class-ab/open-soccer/PCBs/KICAD PARTS/OpenMV RT0162 CAD/ov5640.png

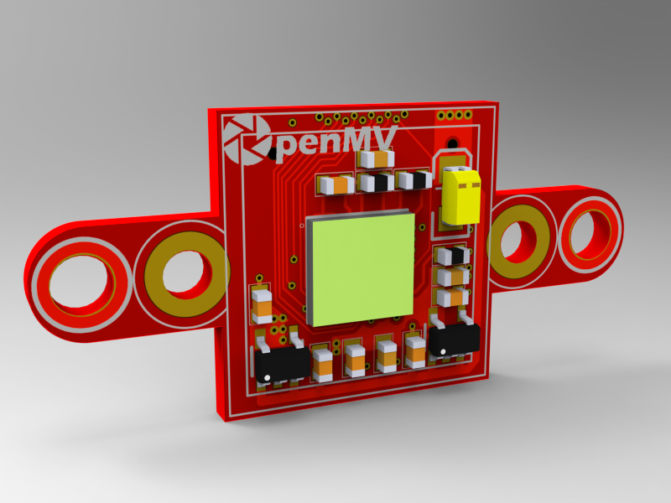
PCBs/KICAD PARTS/OpenMV RT0162 CAD/ov5640.png
