class-ab/open-soccer/README.md

contains all the PCBs, code and general shared documentation used in the creation of Mindstormers' open soccer robot/s (2026+)

CAD: https://cad.onshape.com/documents/fc0a5e085ca7f56b4458a98d/w/3d7a112d05c35eb898b84bfe/e/c55f60db607fb82f3faf3afa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
