class-ab/open-soccer/software/simulation/README.md

# RCJ Open Soccer — 2D Simulation (SFML)

A minimal 2D simulation of an RCJ Open Soccer field with a single robot (with a
frontal dribbler) and a ball. It runs the real robot firmware on a background
thread through a simulator HAL, so the robot's `loop()` runs while the render
loop animates the field.

## Field constants

- Total green area: 2430 mm (width) x 1820 mm (height), matching robot localization
- White lines: 50 mm thick, positioned 250 mm from the walls on every side
  (these form the play border)
- Goals: 450 mm wide, centered on the left and right short sides, 74 mm deep
  from the inner edge of the white line
- Robot: 180 mm diameter (configurable) with a 40 mm wide frontal dribbler bar
- Ball: 40 mm diameter

All constants live at the top of `src/main.cpp` and are expressed in
millimetres, so sizes and the rendering scale can be tweaked easily.

## Physics / behaviour

- Ball and robot are clamped to the field walls; goals are solid boxes.
- Dragging/dropping the ball places it exactly where the cursor is (drag
  follows the mouse, clamped only to the field). It can be placed over or
  behind a goal — it no longer snaps to the goal surface.
- Rolling ball friction, wall/goal bounces, and robot-ball contact are
  simulated.
- Dribbling: the sim reads the shared `dribblerShouldRun` flag. When the robot
  requests the dribbler and the ball touches the frontal dribbler bar, the ball
  is held against the bar and follows the robot through translation and
  rotation. It releases when the dribbler is switched off or the user grabs it.
- No scoring yet: the ball is kept out of the goal boxes themselves.

## Build

Requires CMake and SFML. On Windows the project has been built with Visual
Studio 2022 (generated with `cmake -G "Visual Studio 17 2022"`).

```
cmake -S . -B build
cmake --build build --config Release
```

Then run `build\Release\simulation.exe` (Windows) or `build/simulation`
(Linux/macOS).

> The sim runs the current robot entry point, vision, drivebase, state, and
> strategy modules from `../code/src`. Simulator localization, IMU, radio,
> display, battery, dribbler, and kicker adapters replace hardware I/O while
> preserving the firmware interfaces. Robot control runs once per simulation
> frame; the position and heading PID values come from `robot_config.h`.

If CMake cannot find SFML, install it for your platform (vcpkg, apt, brew, …)
and make sure it is discoverable by CMake.

## Usage

Mouse:
- Left-drag on the **robot** to move it (uses goal collision).
- Left-drag on the **ball** to move it (follows the cursor, field-only).
  Releasing places the ball exactly there.

Keyboard:
- `R` — reset robot to field centre
- `Space` — enable or disable the robots
- `Escape` — quit (or cancel an in-progress HUD text edit)

HUD panel (right side):
- **Enable / Disable** buttons toggle the robot firmware run state.
- **Move** and **Rot** fields set calibration scales (default `1.0`) when
  applying the robot's active `MoveProfile`. Linear motion uses the configured
  robot speed and a `0.9` slip modifier.
- Readouts: BallPacket (detected / angle / distance), MoveProfile (active /
  direction / speed / rotation), and Dribbler + Ball held state.

## Files

- `src/main.cpp` — main simulation, physics/collision, rendering, input, HUD
- `src/robot_wrapper.cpp` — runs `setup()`/`loop()` of the firmware on a thread
- `src/sim_hal/` — Arduino-style shim (`Arduino.h`) and simulator time control
- `src/sim_stubs/` — stubbed firmware peripherals (display, IMU, dribbler, battery)
- `src/sim_state.cpp` — shared `currentMoveProfile`, `dribblerShouldRun`, etc.
- `CMakeLists.txt` — CMake project
