class-ab/open-soccer/hardware/mirror/mirror_profile.csv

radius_mm | height_mm
0.0 | 42.74874000408491
0.008395794528244623 | 42.74874000408491
0.016791598710504473 | 42.74876293276296
0.02518742670333748 | 42.74880878906418
0.033583292661637655 | 42.748877570862064
0.04197921073758713 | 42.7489692749592
0.05037519507960946 | 42.7490838970883
0.058771259831324495 | 42.74922143191357
0.06716741913050564 | 42.74938187303248
0.07556368710803954 | 42.749565212977835
0.08396007788688907 | 42.74977144322013
0.09235660558105975 | 42.75000055417042
0.10075328429457031 | 42.75025253518333
0.10915012812042778 | 42.750527374560534
0.11754715113960738 | 42.75082505955451
0.125944367420038 | 42.751145576372615
0.13434179101559346 | 42.75148891018157
0.1427394359650898 | 42.7518550451121
0.15113731629128987 | 42.75224396426412
0.15953544599991443 | 42.75265564971201
0.1679338390786611 | 42.75309008251036
0.17633250949623125 | 42.753547242699945
0.1847314712013652 | 42.75402710931401
0.19313073812188622 | 42.75452966038489
0.2015303241637534 | 42.75505487295083
0.2099302432101243 | 42.7556027230632
0.21833050912042753 | 42.75617318579391
0.22673113572944514 | 42.75676623524316
0.23513213684640571 | 42.75738184454736
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
