class-ab/open-soccer/hardware/mirror/mirror_rays.png

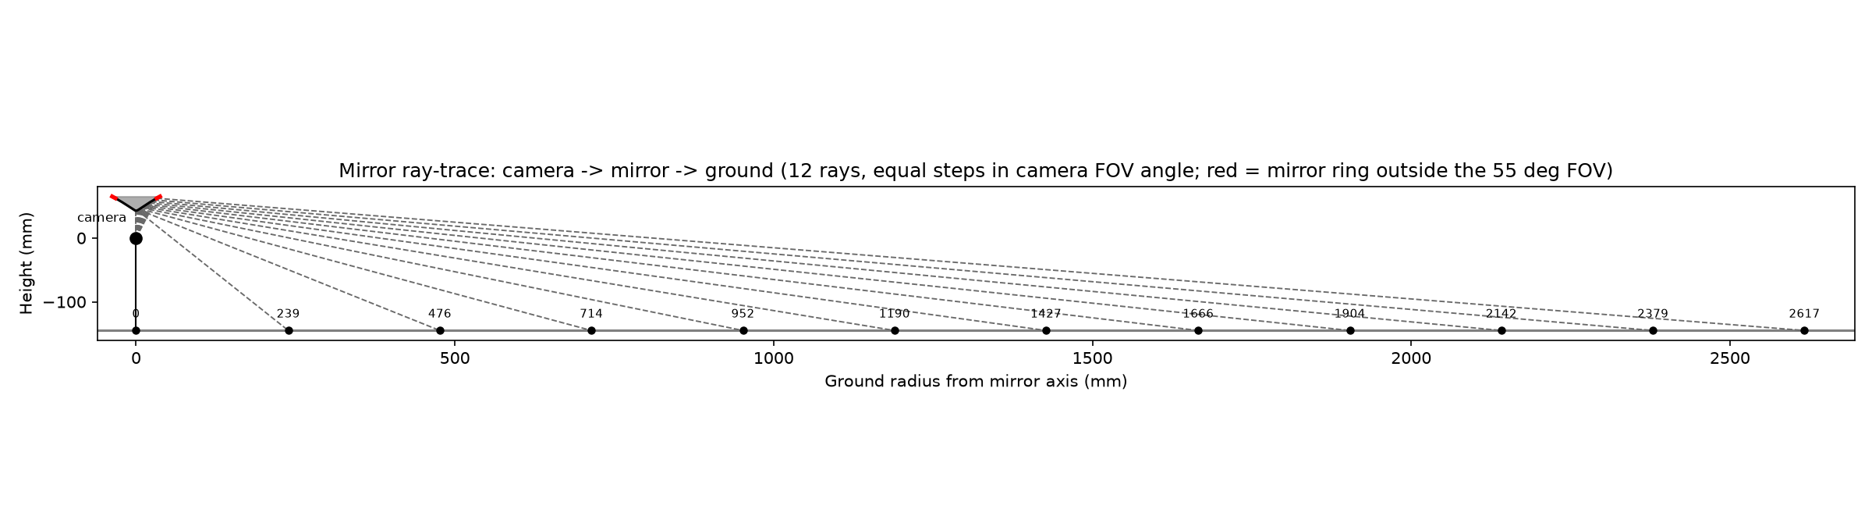
hardware/mirror/mirror_rays.png
