class-ab/open-soccer/PCBs/kicker/v1 review/kicker-bottom-3D.png

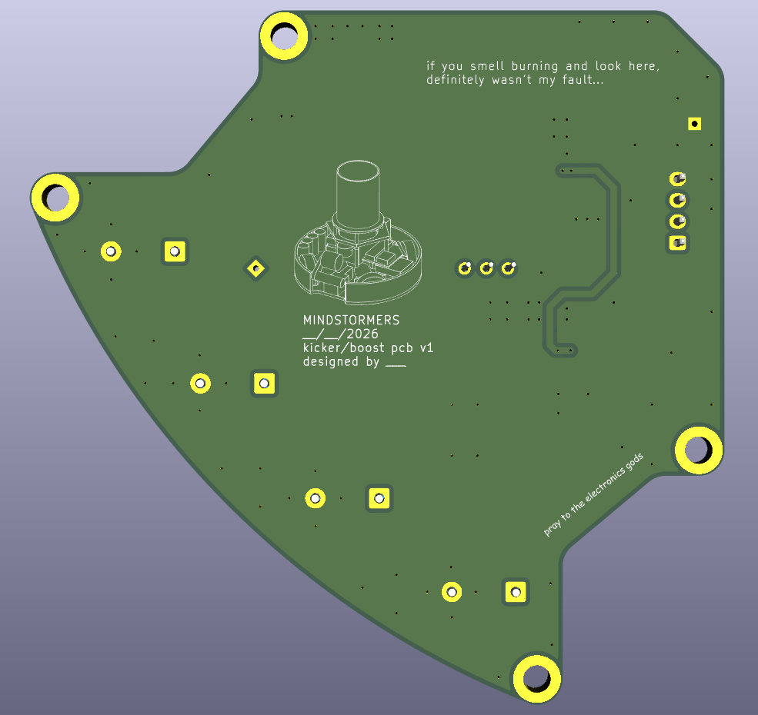
PCBs/kicker/v1 review/kicker-bottom-3D.png
