class-ab/open-soccer/PCBs/kicker/v1 review/PCB-back.png

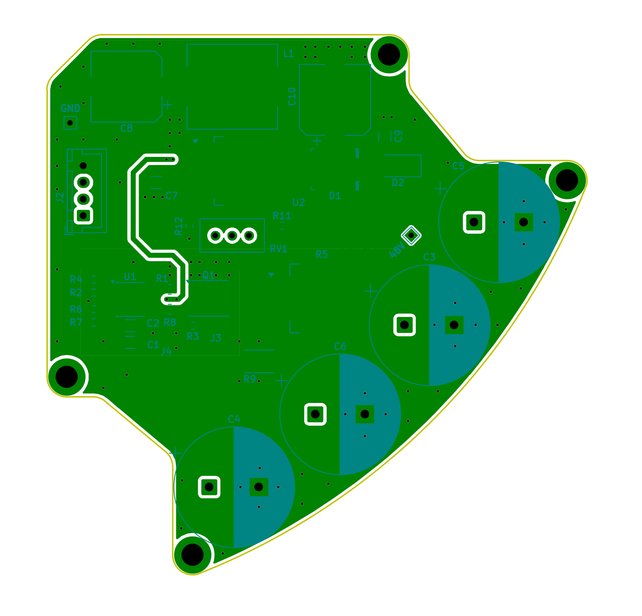
PCBs/kicker/v1 review/PCB-back.png
