class-ab/open-soccer/PCBs/kicker/v1 review/PCB-front.png

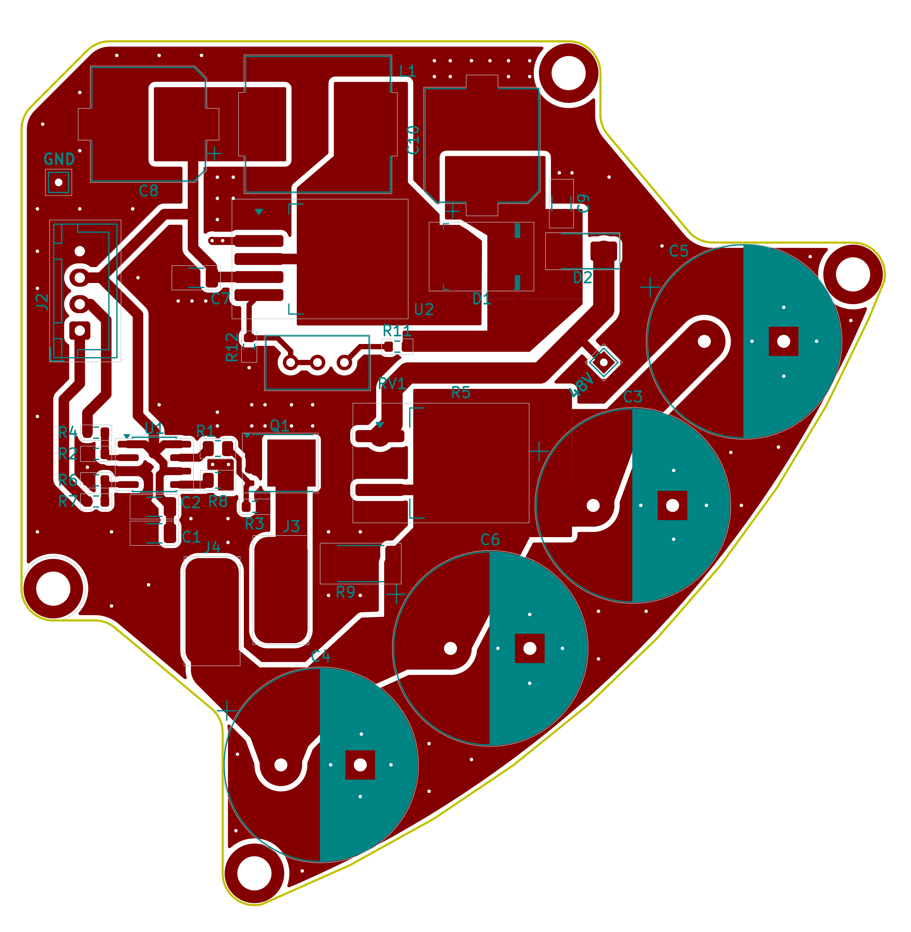
PCBs/kicker/v1 review/PCB-front.png
