class-ab/open-soccer/PCBs/kicker/v1 review/schematic.png

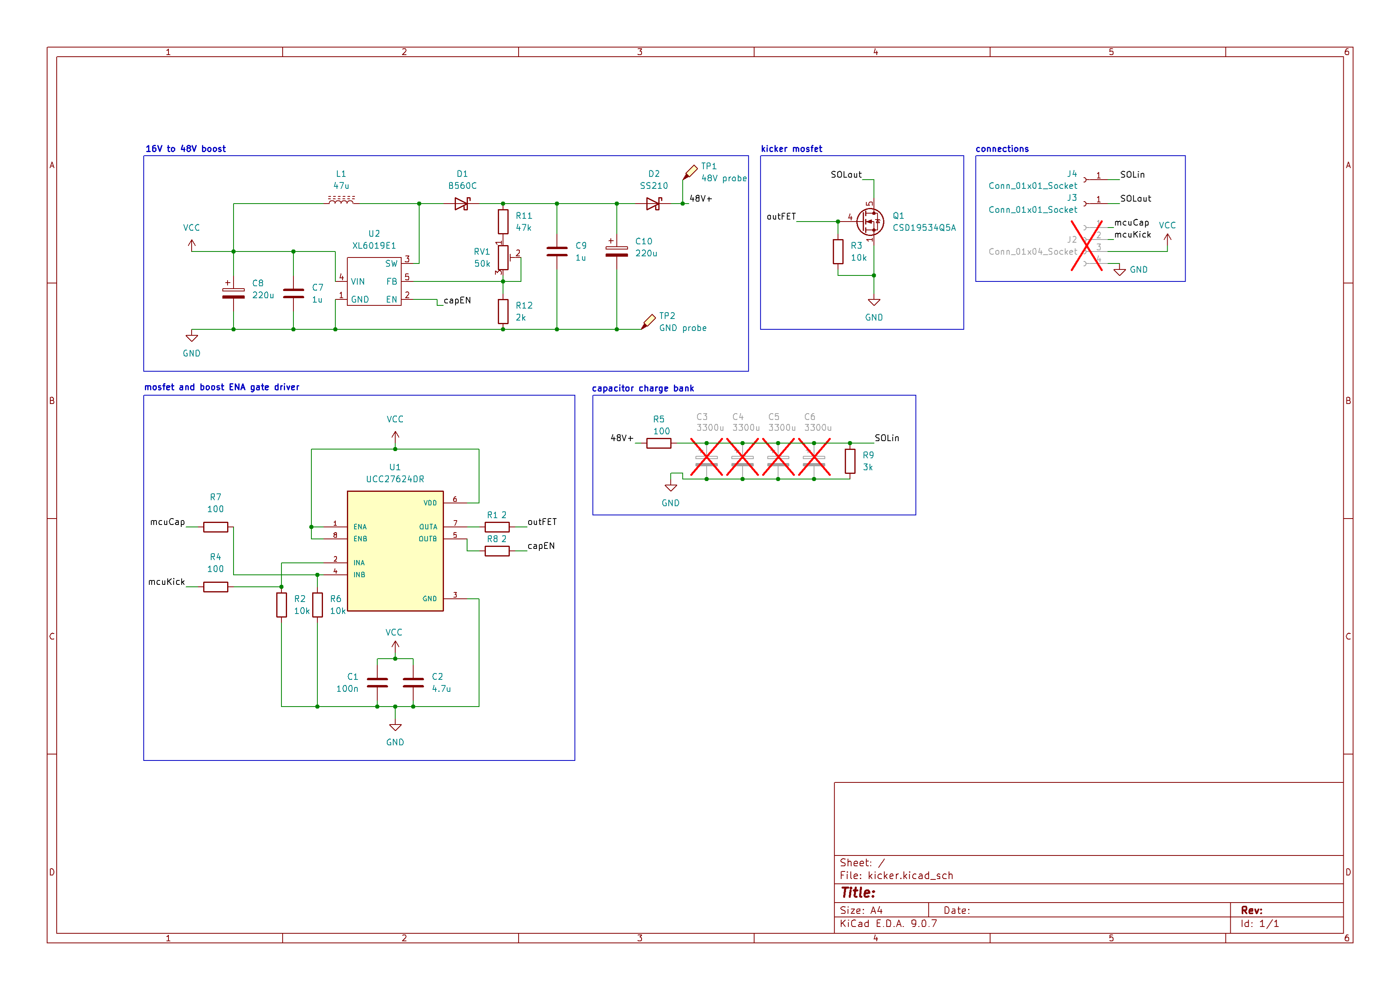
PCBs/kicker/v1 review/schematic.png
