class-ab/open-soccer/PCBs/kicker/v1 review/Screenshot 2026-04-18 172316.png

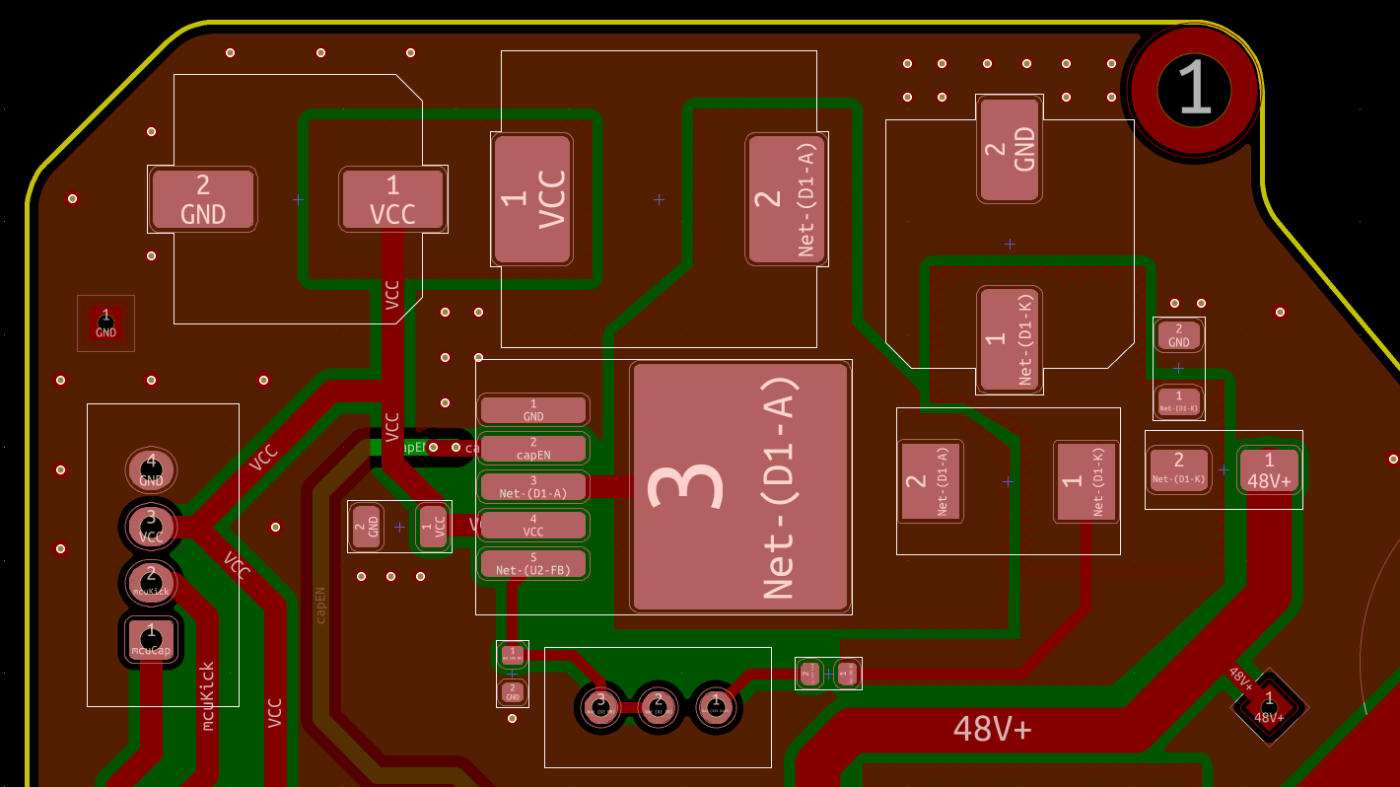
PCBs/kicker/v1 review/Screenshot 2026-04-18 172316.png
