class-ab/open-soccer/robot_strategy.png

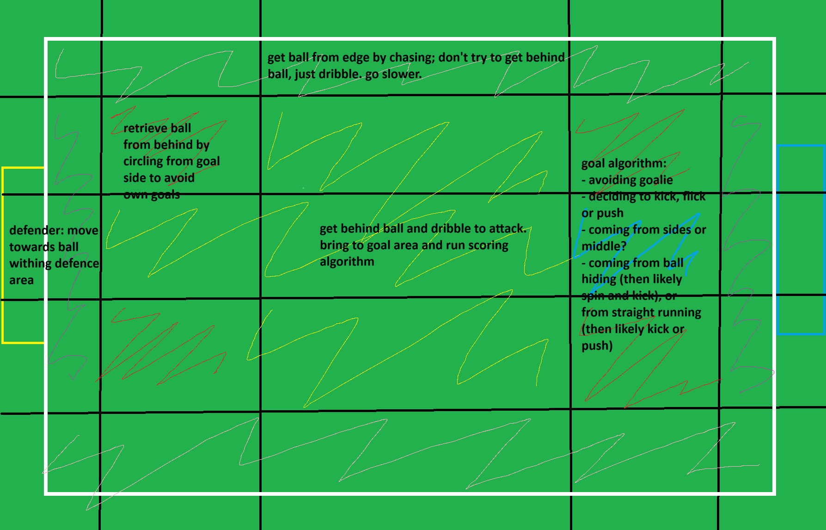
robot_strategy.png
