class-ab/open-soccer/PCBs/KICAD PARTS/OpenMV RT0162 CAD/openmv-cam-rt1062.png

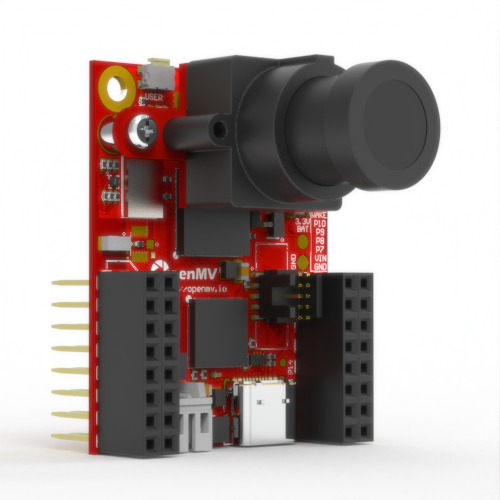
PCBs/KICAD PARTS/OpenMV RT0162 CAD/openmv-cam-rt1062.png
