class-ab/open-soccer/PCBs/KICAD PARTS/OpenMV RT0162 CAD/RT1062 R5.png

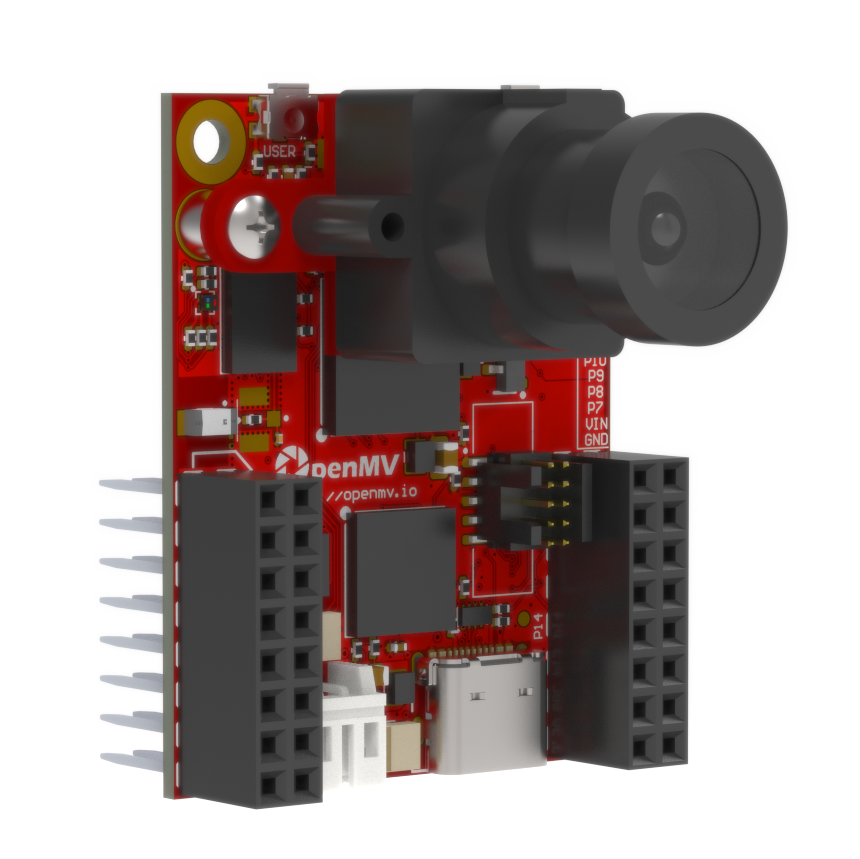
PCBs/KICAD PARTS/OpenMV RT0162 CAD/RT1062 R5.png
