class-ab/open-soccer/PCBs/bottom/bottom PCB.step

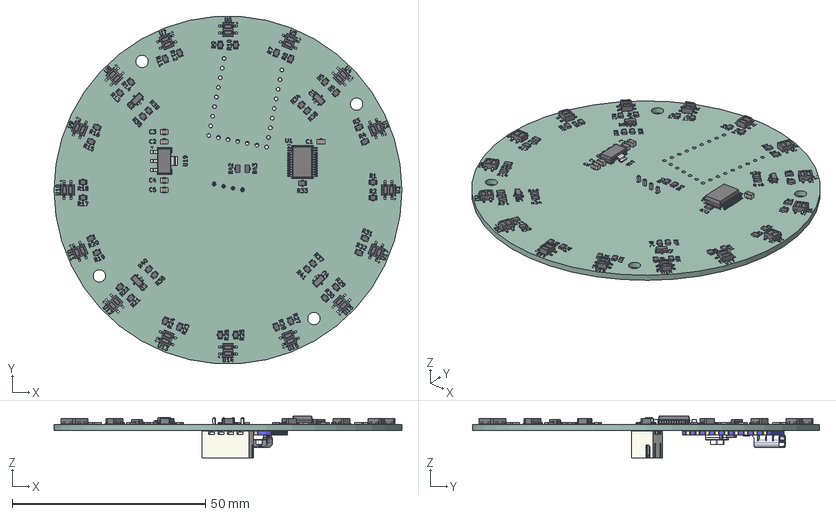
[picture p18: CAD file, 2026-04-25]
PCBs/bottom/bottom PCB.step
90.0 x 89.7 x 10.8 mm
R_0805_2012Metric x 43
SOT-23 x 4
OnSemi_CASE100CY x 16
C_0805_2012Metric x 5
SOT-223
SSOP-24_5.3x8.2mm_P0.65mm
RP2040-ZERO
JST_XH_B4B-XH-A_1x04_P2.50mm_Vertical
soccer bottom_silkscreen x 2
soccer bottom_PCB
