class-ab/open-soccer/PCBs/KICAD PARTS/Footprints/RFM98W-433S2.STEP

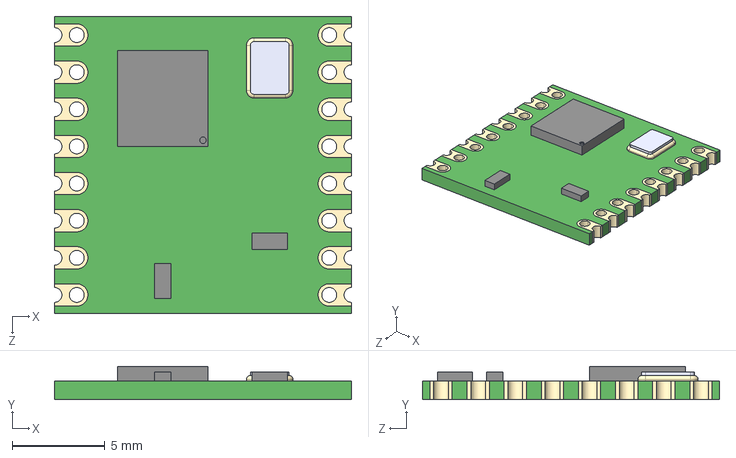
[picture p19: CAD file, 2026-05-23]
PCBs/KICAD PARTS/Footprints/RFM98W-433S2.STEP
16.0 x 1.80 x 16.0 mm
