class-ab/open-soccer/PCBs/KICAD PARTS/OpenMV RT0162 CAD/ov5640.step

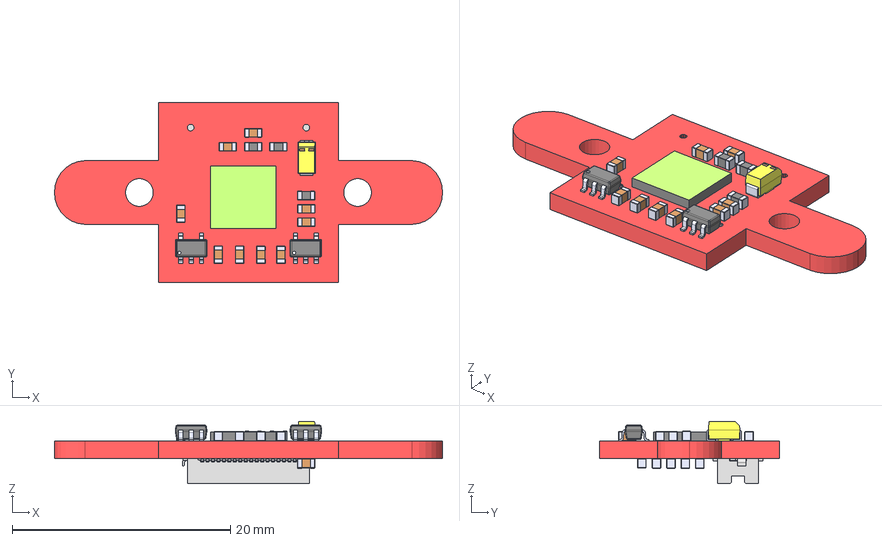
[picture p20: CAD file, 2026-03-09]
PCBs/KICAD PARTS/OpenMV RT0162 CAD/ov5640.step
35.6 x 16.5 x 5.70 mm
DF1236
CAP pt1 uF 0603 x 7
CAP 10 uF 0603 x 3
Ferrite Bead 0603
CAP 1 uF 0603 x 6
Tantalum Capacitors 3216 47uf
MOSFET SOT23_5 x 2
OV5640
