class-ab/open-soccer/PCBs/kicker/kicker.step

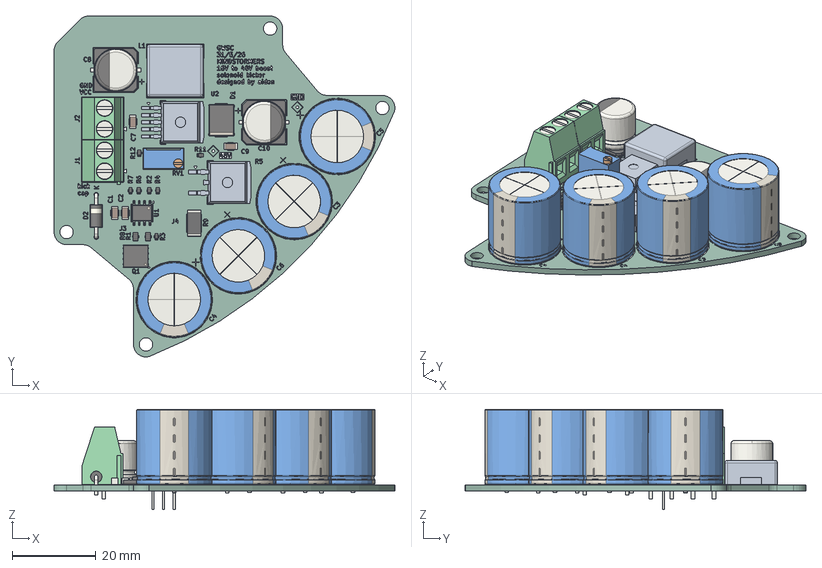
[picture p21: CAD file, 2026-05-31]
PCBs/kicker/kicker.step
81.5 x 81.6 x 24.0 mm
R_0603_1608Metric x 7
R_0805_2012Metric x 2
C_1206_3216Metric x 4
D_DO-41_SOD81_P10.16mm_Horizontal
CP_Radial_D18.0mm_P7.50mm x 4
Potentiometer_Bourns_3296W_Vertical
kicker 1.9.1
CP_Elec_10x10.5 x 2
kicker 1.14.1
SOIC-8_3.9x4.9mm_P1.27mm
D_SMC
TDSON-8-1
TerminalBlock_Phoenix_MKDS-1,5-2_1x02_P5.00mm_Horizontal x 2
kicker 1.23.1
R_2512_6332Metric
kicker_silkscreen x 2
kicker_PCB
