class-ab/open-soccer/PCBs/middle/middle/middle PCB.step

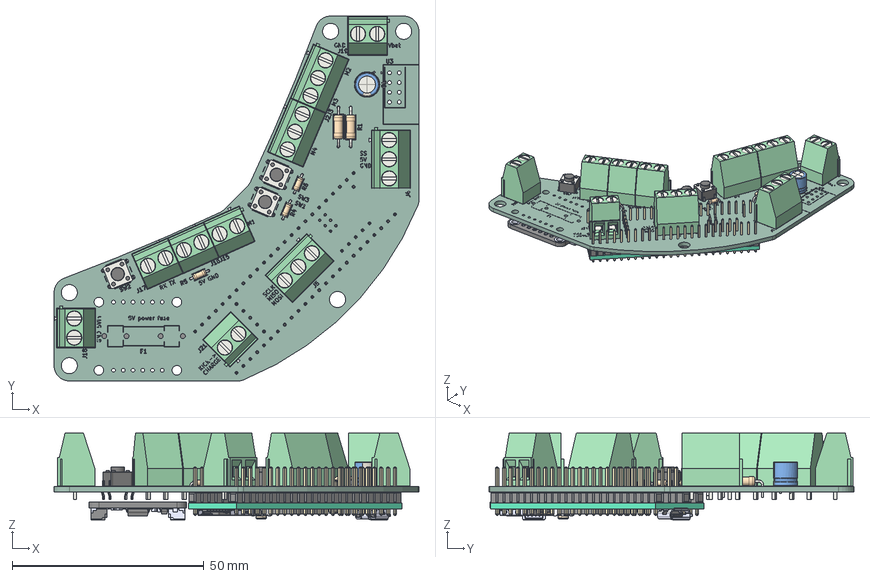
[picture p22: CAD file, 2026-05-31]
PCBs/middle/middle/middle PCB.step
95.1 x 95.1 x 22.6 mm
TerminalBlock_Phoenix_MKDS-1,5-3_1x03_P5.00mm_Horizontal x 4
R_Axial_DIN0207_L6.3mm_D2.5mm_P10.16mm_Horizontal x 2
TerminalBlock_Phoenix_MKDS-1,5-2_1x02_P5.00mm_Horizontal x 6
R_Axial_DIN0204_L3.6mm_D1.6mm_P5.08mm_Horizontal x 3
SW_PUSH_6mm_H5mm x 3
CP_Radial_D6.3mm_P2.50mm
SPX5205M5
MAX4661CAE+
DEV-16771
middle_silkscreen x 2
middle_PCB
