class-ab/open-soccer/PCBs/KICAD PARTS/Footprints/DM-OLED096-636.step

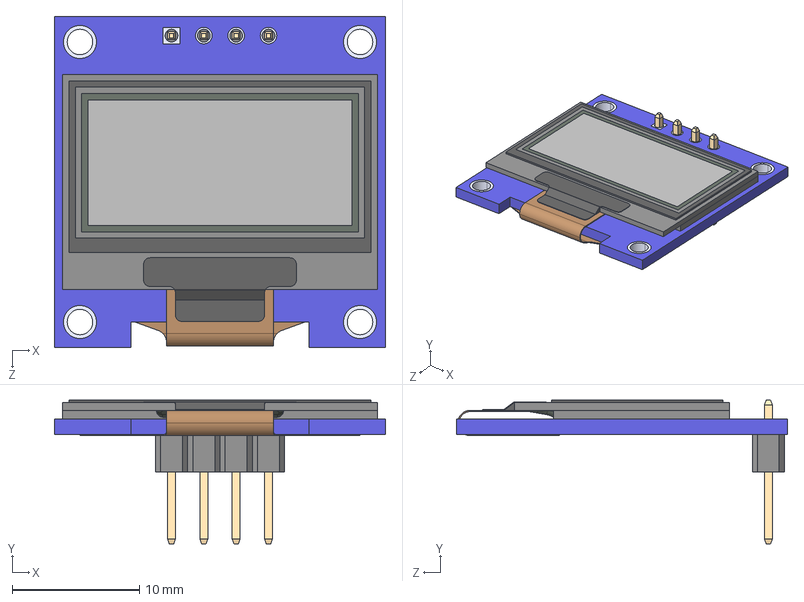
[picture p24: CAD file, 2026-05-07]
PCBs/KICAD PARTS/Footprints/DM-OLED096-636.step
26.0 x 11.3 x 26.0 mm
DM-OLED096-636_Module
DM-OLED096-636_Panel
