class-ab/open-soccer/PCBs/KICAD PARTS/Footprints/4754.step

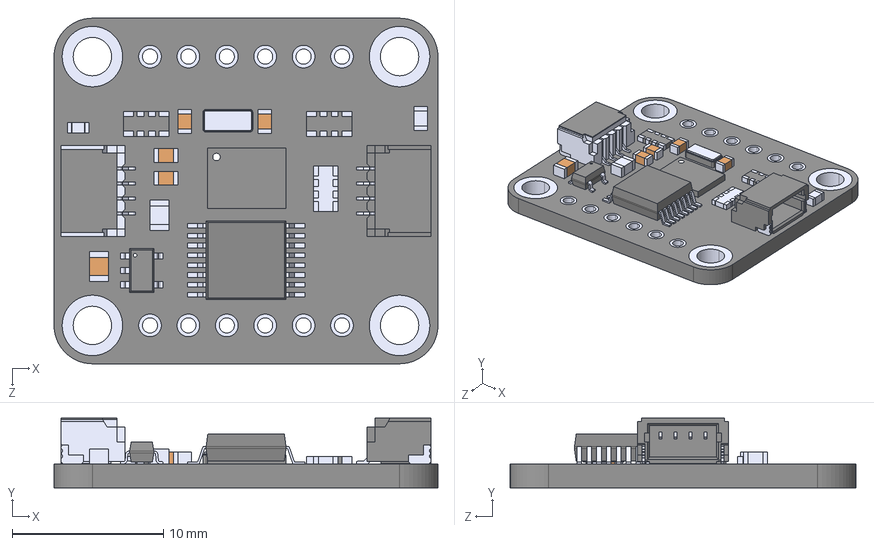
[picture p25: CAD file, 2026-05-03]
PCBs/KICAD PARTS/Footprints/4754.step
25.4 x 4.60 x 22.9 mm
SPX5205M5
MAX4661CAE+
