class-ab/open-soccer/PCBs/KICAD PARTS/Footprints/DEV-15583--3DModel-STEP-56544.STEP

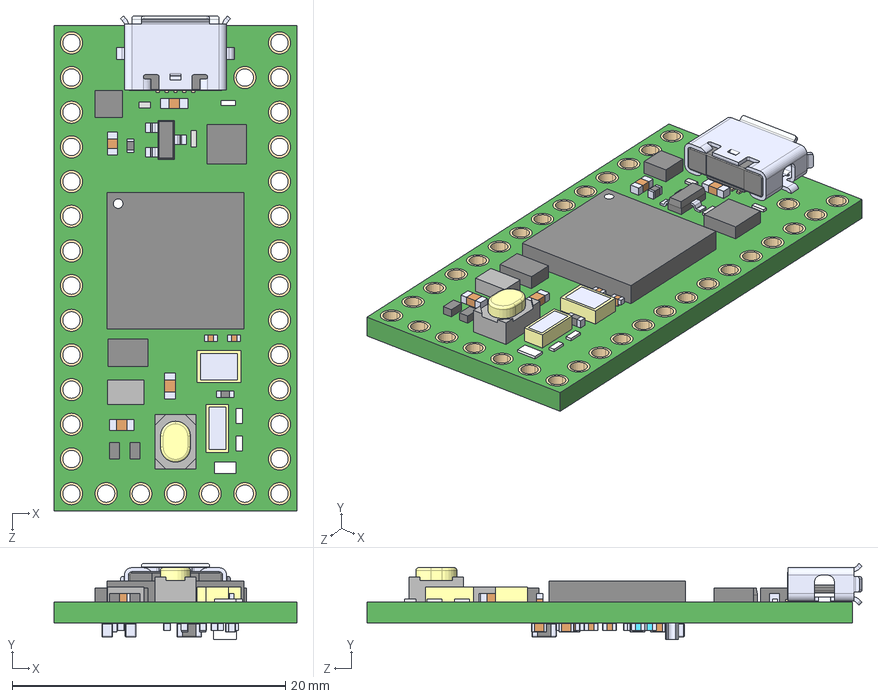
[picture p26: CAD file, 2026-03-31]
PCBs/KICAD PARTS/Footprints/DEV-15583--3DModel-STEP-56544.STEP
17.8 x 5.58 x 36.3 mm
DEV-15583 board
C5-C18 (0.55mm)
C20-C24 (0.65)
R1-R3 (0.4inch)_1269AS-H-3R3M=P2
L1^DEV-15583 ASS
C x 2
C2
