class-ab/open-soccer/PCBs/KICAD PARTS/Footprints/RP2040-ZERO.step

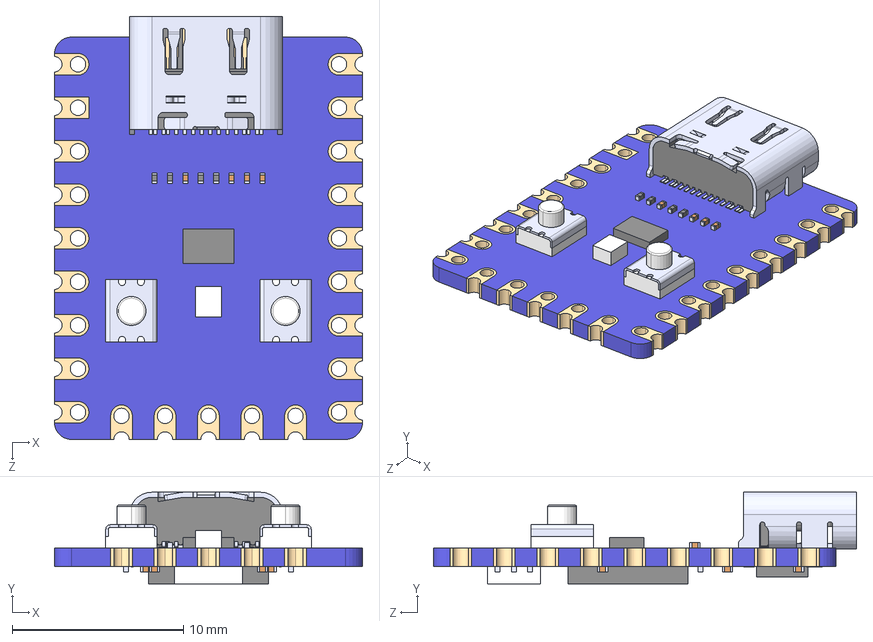
[picture p27: CAD file, 2026-03-31]
PCBs/KICAD PARTS/Footprints/RP2040-ZERO.step
18.0 x 5.35 x 24.7 mm
