class-ab/open-soccer/PCBs/KICAD PARTS/Footprints/DEV-16771.step

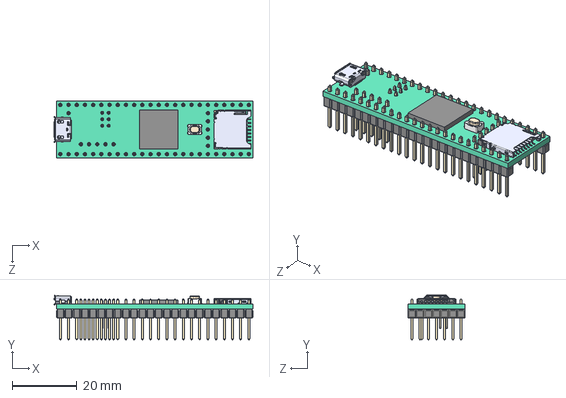
[picture p28: CAD file, 2026-03-31]
PCBs/KICAD PARTS/Footprints/DEV-16771.step
61.7 x 13.8 x 17.8 mm
