class-ab/open-soccer/PCBs/KICAD PARTS/Footprints/UCC27624DR.step

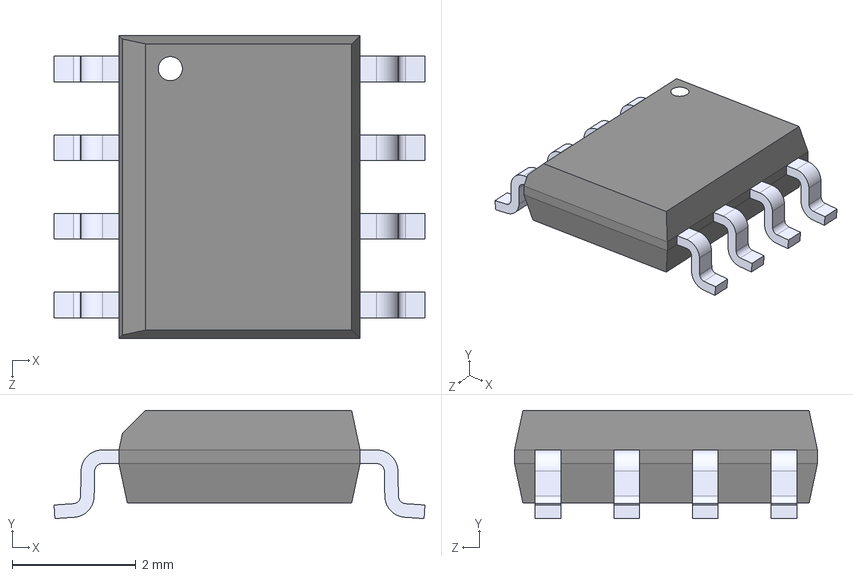
[picture p29: CAD file, 2026-03-31]
PCBs/KICAD PARTS/Footprints/UCC27624DR.step
6.00 x 1.75 x 4.90 mm
