class-ab/open-soccer/(list of files, cad)

Other CAD files:
hardware/mirror/mirror_profile_points.dxf
hardware/mirror/mirror_profile.dxf
