class-ab/open-soccer/PCBs/middle/middle/middle.kicad_pcb

## KiCad design PCBs/middle/middle/middle.kicad_pcb (2026-06-08)

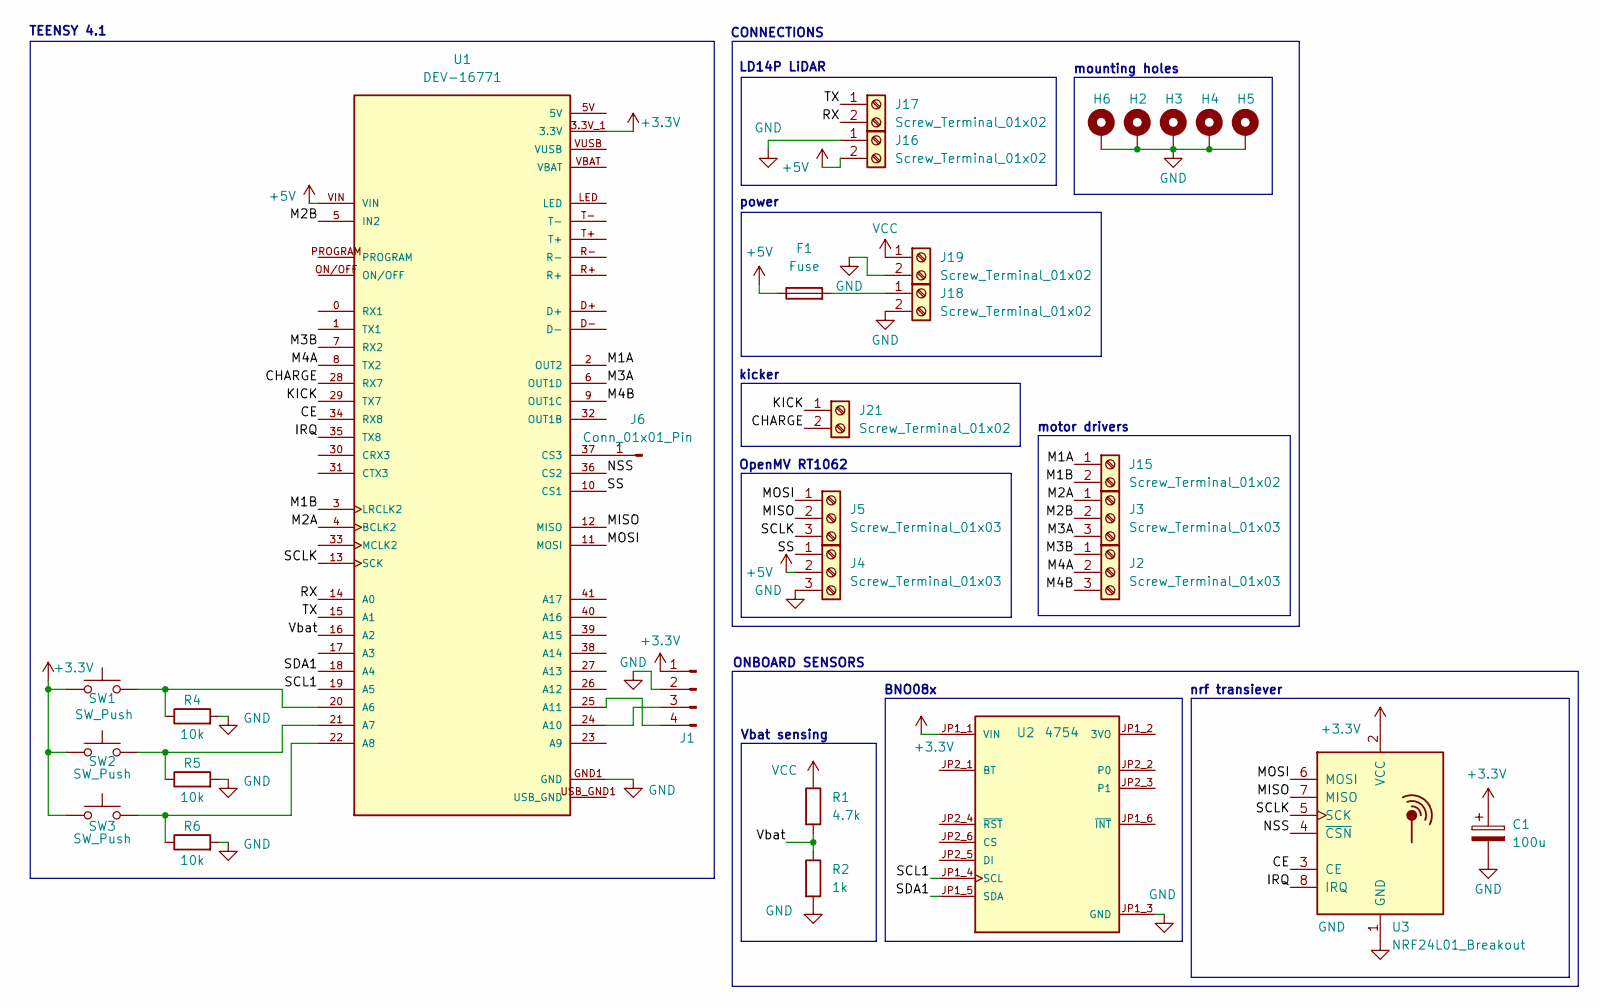
[picture p30: schematic middle.kicad_sch]

Parts:
C1: 100u; CP_Radial_D6.3mm_P2.50mm
F1: Fuse; Fuseholder_Clip-5x20mm_Littelfuse_520_Inline_P20.50x5.80mm_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
H2, H3, H4, H5, H6: MountingHole_Pad; MountingHole_3.2mm_M3_DIN965_Pad
J1: Conn_01x04_Pin; PinSocket_1x04_P2.54mm_Vertical
J2, J3, J4, J5: Screw_Terminal_01x03; TerminalBlock_Phoenix_MKDS-1,5-3_1x03_P5.00mm_Horizontal
J6: Conn_01x01_Pin; PinHeader_1x01_P2.54mm_Vertical
J15, J16, J17, J18, J19, J21: Screw_Terminal_01x02; TerminalBlock_Phoenix_MKDS-1,5-2_1x02_P5.00mm_Horizontal
R1: 4.7k; R_Axial_DIN0207_L6.3mm_D2.5mm_P10.16mm_Horizontal
R2: 1k; R_Axial_DIN0207_L6.3mm_D2.5mm_P10.16mm_Horizontal
R4, R5, R6: 10k; R_Axial_DIN0204_L3.6mm_D1.6mm_P5.08mm_Horizontal
SW1, SW2, SW3: SW_Push; SW_PUSH_6mm_H5mm
U1: DEV-16771; MODULE_DEV-16771; PARTREV 4.1
U2: 4754; MODULE_4754; PARTREV 2021-03-16
U3: NRF24L01_Breakout; nRF24L01_Breakout

Connections:
+3.3V: C1.1, J1.1, SW1.1, SW2.1, SW3.1, U1.3.3V_1 (3.3V), U1.3.3V_2 (3.3V), U1.3.3V_3 (3.3V), U2.JP1_1 (VIN), U3.2 (VCC)
+5V: F1.1, J4.2, J16.2, U1.VIN
/CE: U1.34 (RX8), U3.3 (CE)
/CHARGE: J21.2, U1.28 (RX7)
/IRQ: U1.35 (TX8), U3.8 (IRQ)
/KICK: J21.1, U1.29 (TX7)
/M1A: J15.1, U1.2 (OUT2)
/M1B: J15.2, U1.3 (LRCLK2)
/M2A: J3.1, U1.4 (BCLK2)
/M2B: J3.2, U1.5 (IN2)
/M3A: J3.3, U1.6 (OUT1D)
/M3B: J2.1, U1.7 (RX2)
/M4A: J2.2, U1.8 (TX2)
/M4B: J2.3, U1.9 (OUT1C)
/MISO: J5.2, U1.12 (MISO), U3.7 (MISO)
/MOSI: J5.1, U1.11 (MOSI), U3.6 (MOSI)
/NSS: U1.36 (CS2), U3.4 (~CSN)
/RX: J17.2, U1.14 (A0)
/SCL1: U1.19 (A5), U2.JP1_4 (SCL)
/SCLK: J5.3, U1.13 (SCK), U3.5 (SCK)
/SDA1: U1.18 (A4), U2.JP1_5 (SDA)
/SS: J4.1, U1.10 (CS1)
/TX: J17.1, U1.15 (A1)
/Vbat: R1.2, R2.1, U1.16 (A2)
GND: C1.2, H2.1 (1_1), H3.1 (1_1), H4.1 (1_1), H5.1 (1_1), H6.1 (1_1), J1.2, J4.3, J16.1, J18.2, J19.2, R2.2, R4.2, R5.2, R6.2, U1.GND1 (GND), U1.GND2 (GND), U1.GND3 (GND), U1.GND4 (GND), U1.GND5 (GND), U2.JP1_3 (GND), U3.1 (GND)
unnamed: J1.3, U1.24 (A10)
unnamed: J1.4, U1.25 (A11)
unnamed: J6.1 (Pin_1_1), U1.37 (CS3)
unnamed: F1.2, J18.1
unnamed: R4.1, SW1.2, U1.20 (A6)
unnamed: R5.1, SW2.2, U1.21 (A7)
unnamed: R6.1, SW3.2, U1.22 (A8)
USB_GND: U1.USB_GND1 (USB_GND), U1.USB_GND2 (USB_GND)
VCC: J19.1, R1.1

Notes on the sheet:
BNO08x
power
LD14P LiDAR
mounting holes
CONNECTIONS
OpenMV RT1062
nrf transiever
TEENSY 4.1
motor drivers
kicker
Vbat sensing
ONBOARD SENSORS

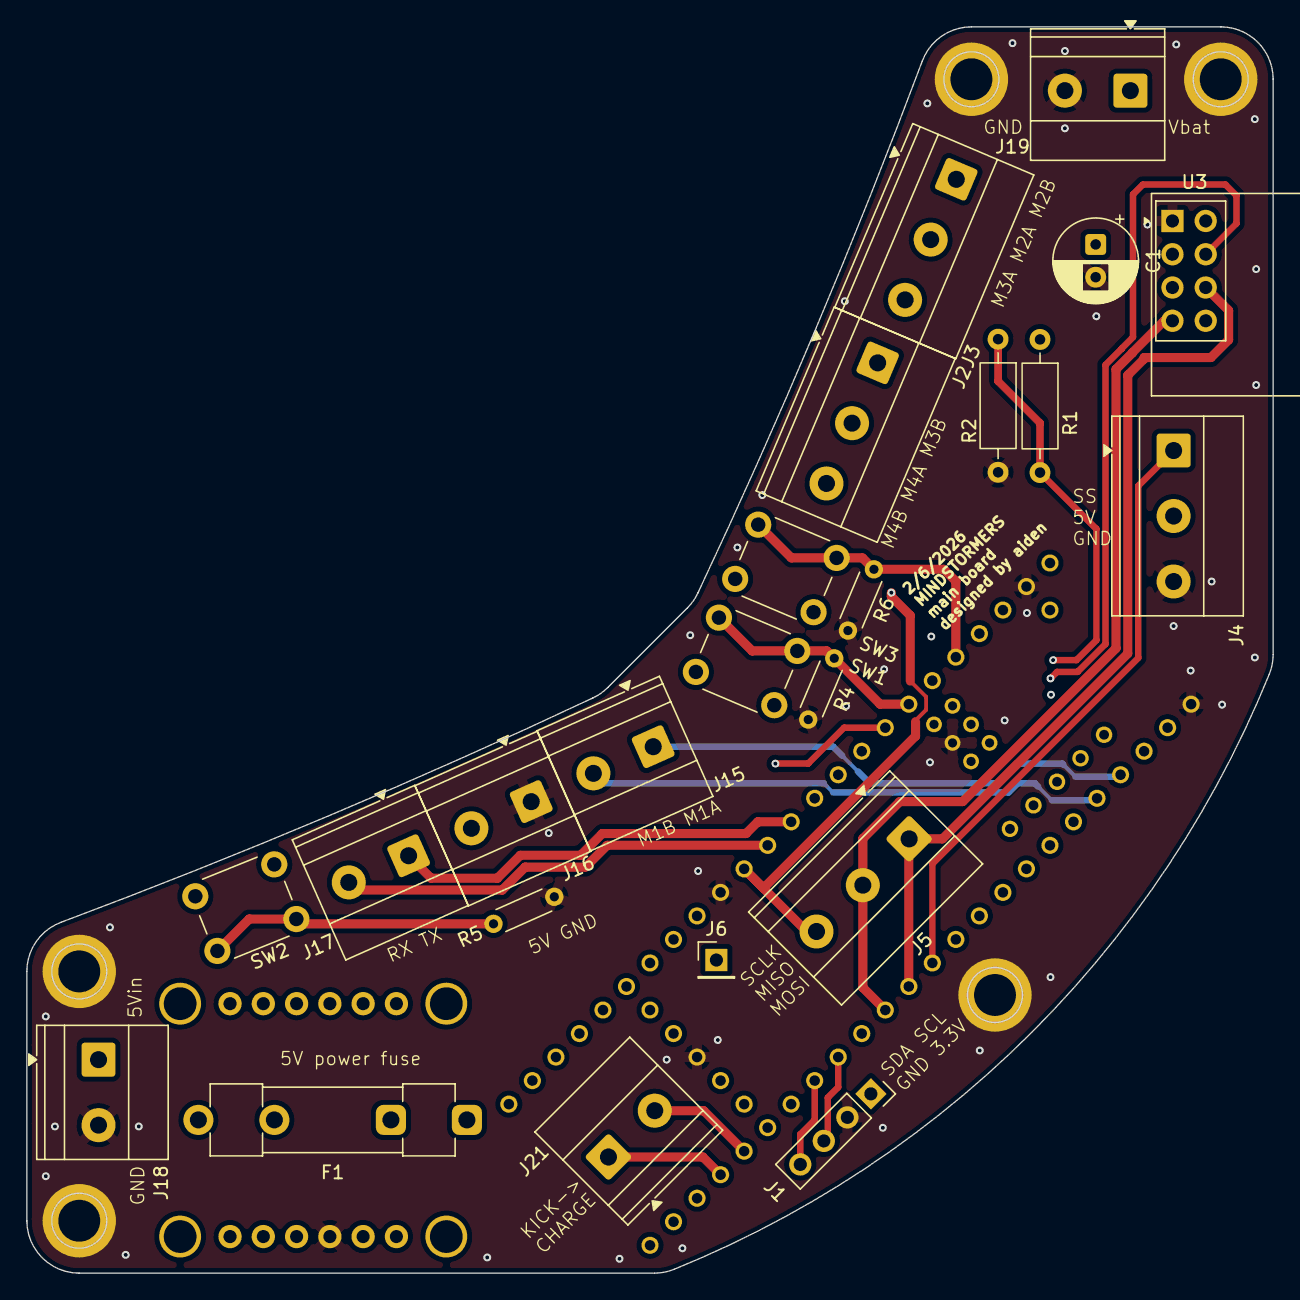
[picture p31: board middle.kicad_pcb from above]

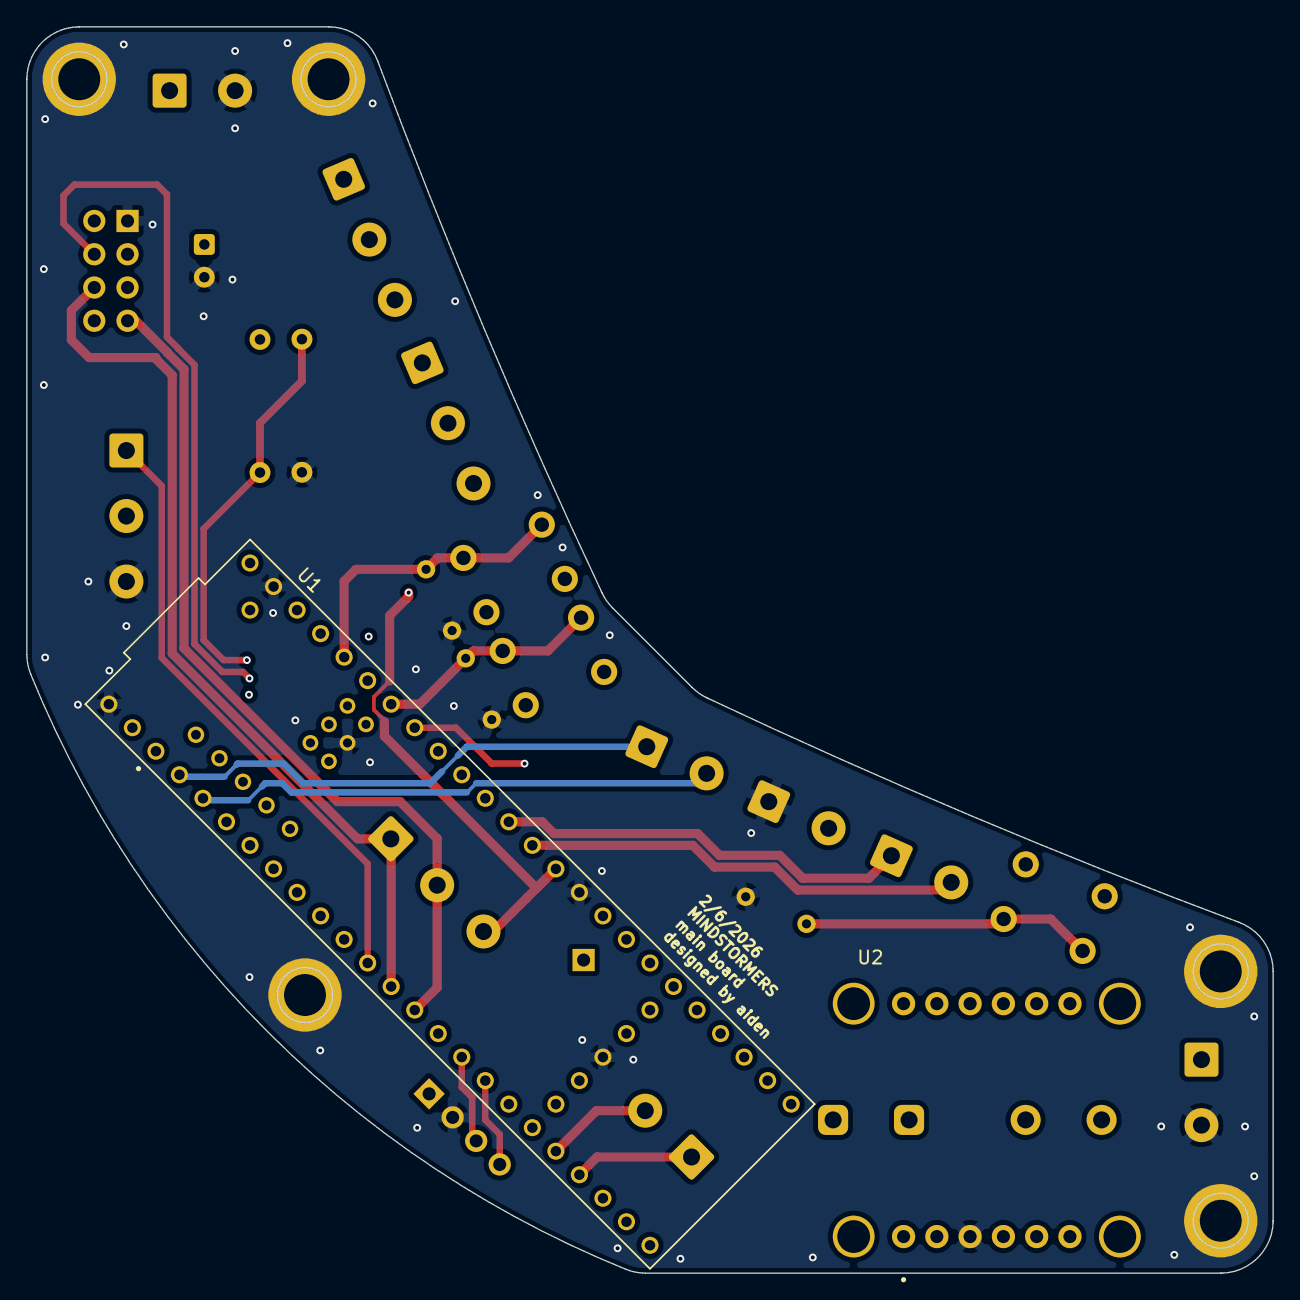
[picture p32: board middle.kicad_pcb from below]

Board: 4 copper layers, 95.1 x 95.1 mm, 30 parts (2 on the bottom side), 34 nets.
