class-ab/open-soccer/PCBs/kicker/kicker.kicad_pcb

## KiCad design PCBs/kicker/kicker.kicad_pcb (2026-06-02)

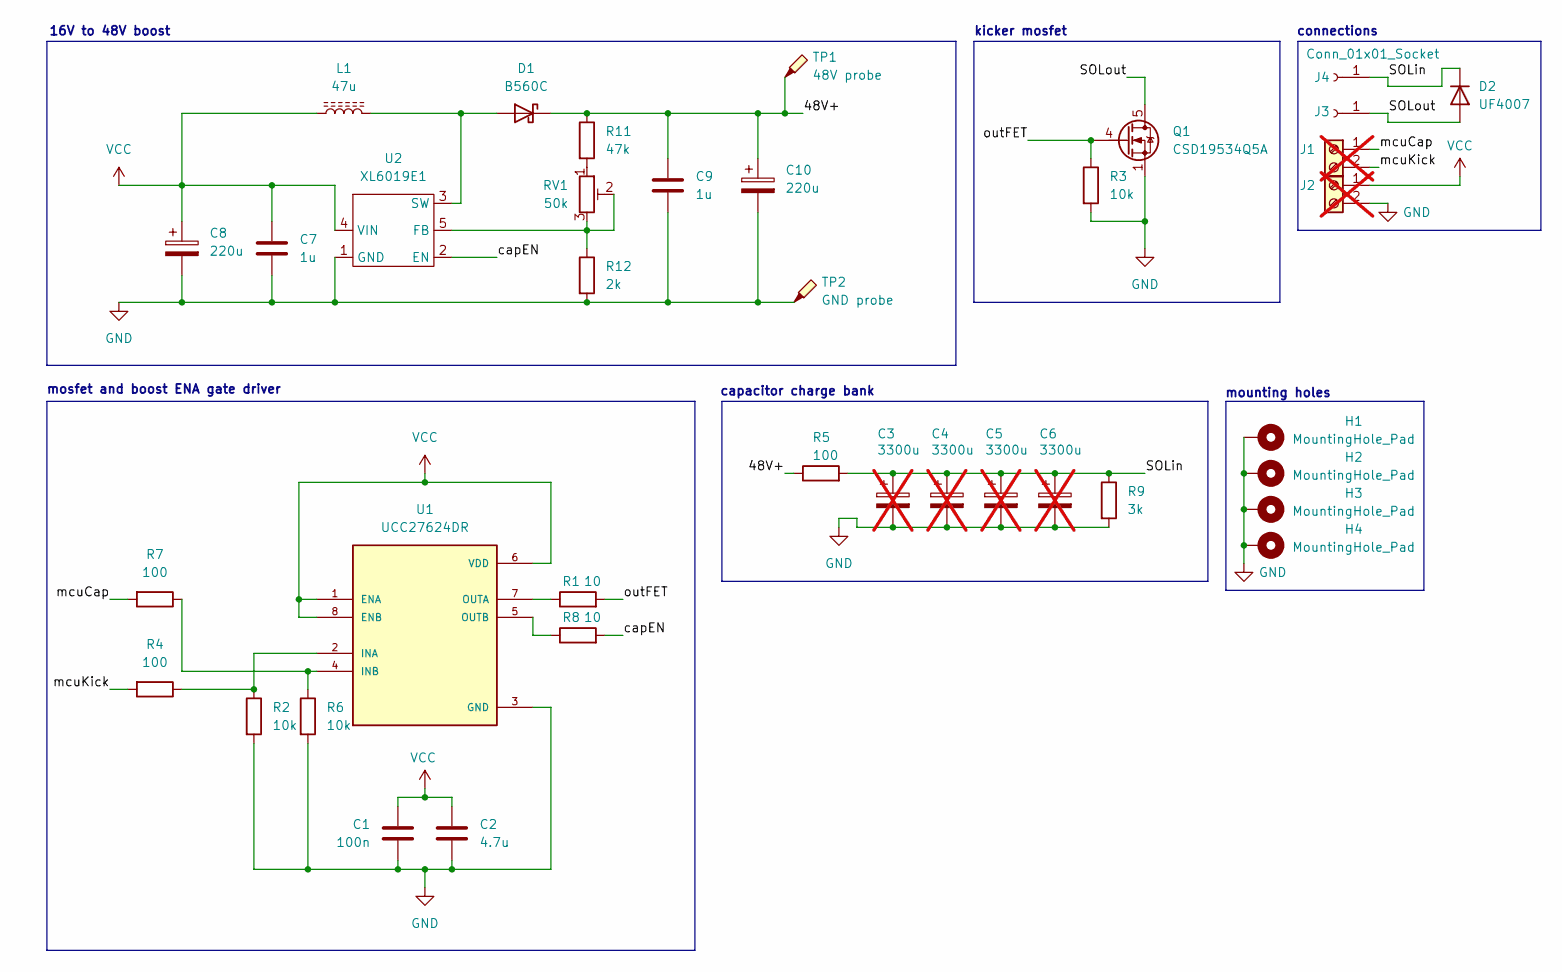
[picture p33: schematic kicker.kicad_sch]

Parts:
C1: 100n; C_1206_3216Metric
C2: 4.7u; C_1206_3216Metric
C3, C4, C5, C6: 3300u; CP_Radial_D18.0mm_P7.50mm; not fitted
C7, C9: 1u; C_1206_3216Metric
C8, C10: 220u; CP_Elec_10x10.5
D1: B560C; DO-214AB
D2: UF4007; D_DO-41_SOD81_P10.16mm_Horizontal
H1, H2, H3, H4: MountingHole_Pad; MountingHole_3.2mm_M3_DIN965_Pad
J1, J2: Screw_Terminal_01x02; TerminalBlock_Phoenix_MKDS-1,5-2_1x02_P5.00mm_Horizontal; not fitted
J3, J4: Conn_01x01_Socket; SolderWirePad_1x01_SMD_3x6mm
L1: 47u; L_Sunlord_MWSA1206S-470
Q1: CSD19534Q5A; TDSON-8-1
R1, R8: 10; R_0805_2012Metric
R2, R3, R6: 10k; R_0603_1608Metric
R4, R7: 100; R_0603_1608Metric
R5: 100; TO-263-2
R9: 3k; R_2512_6332Metric
R11: 47k; R_0603_1608Metric
R12: 2k; R_0603_1608Metric
RV1: 50k; Potentiometer_Bourns_3296W_Vertical
TP1: 48V probe; TestPoint_THTPad_1.5x1.5mm_Drill0.7mm
TP2: GND probe; TestPoint_THTPad_1.5x1.5mm_Drill0.7mm
U1: UCC27624DR; SOIC-8_3.9x4.9mm_P1.27mm; PARTREV B
U2: XL6019E1; TO-263-5_TabPin3

Connections:
/48V+: C9.1, C10.1, D1.1 (K), R5.1, R11.1, TP1.1 (1_1)
/SOLin: C3.1, C4.1, C5.1, C6.1, D2.1 (K), J4.1 (Pin_1_1), R5.2, R9.1
/SOLout: D2.2 (A), J3.1 (Pin_1_1), Q1.5 (D)
/capEN: R8.2, U2.2 (EN)
/mcuCap: J1.1, R7.2
/mcuKick: J1.2, R4.2
/outFET: Q1.4 (G), R1.2, R3.1
GND: C1.2, C2.2, C3.2, C4.2, C5.2, C6.2, C7.2, C8.2, C9.2, C10.2, H1.1 (1_1), H2.1 (1_1), H3.1 (1_1), H4.1 (1_1), J2.2, Q1.1 (S), Q1.2 (S), Q1.3 (S), R2.2, R3.2, R6.2, R9.2, R12.2, TP2.1 (1_1), U1.3 (GND), U2.1 (GND)
unnamed: D1.2 (A), L1.2, U2.3 (SW)
unnamed: R11.2, RV1.1
unnamed: R2.1, R4.1, U1.2 (INA)
unnamed: R6.1, R7.1, U1.4 (INB)
unnamed: R1.1, U1.7 (OUTA)
unnamed: R8.1, U1.5 (OUTB)
unnamed: R12.1, RV1.2, RV1.3, U2.5 (FB)
VCC: C1.1, C2.1, C7.1, C8.1, J2.1, L1.1, U1.1 (ENA), U1.6 (VDD), U1.8 (ENB), U2.4 (VIN)

Notes on the sheet:
connections
mosfet and boost ENA gate driver
capacitor charge bank
mounting holes
16V to 48V boost
kicker mosfet

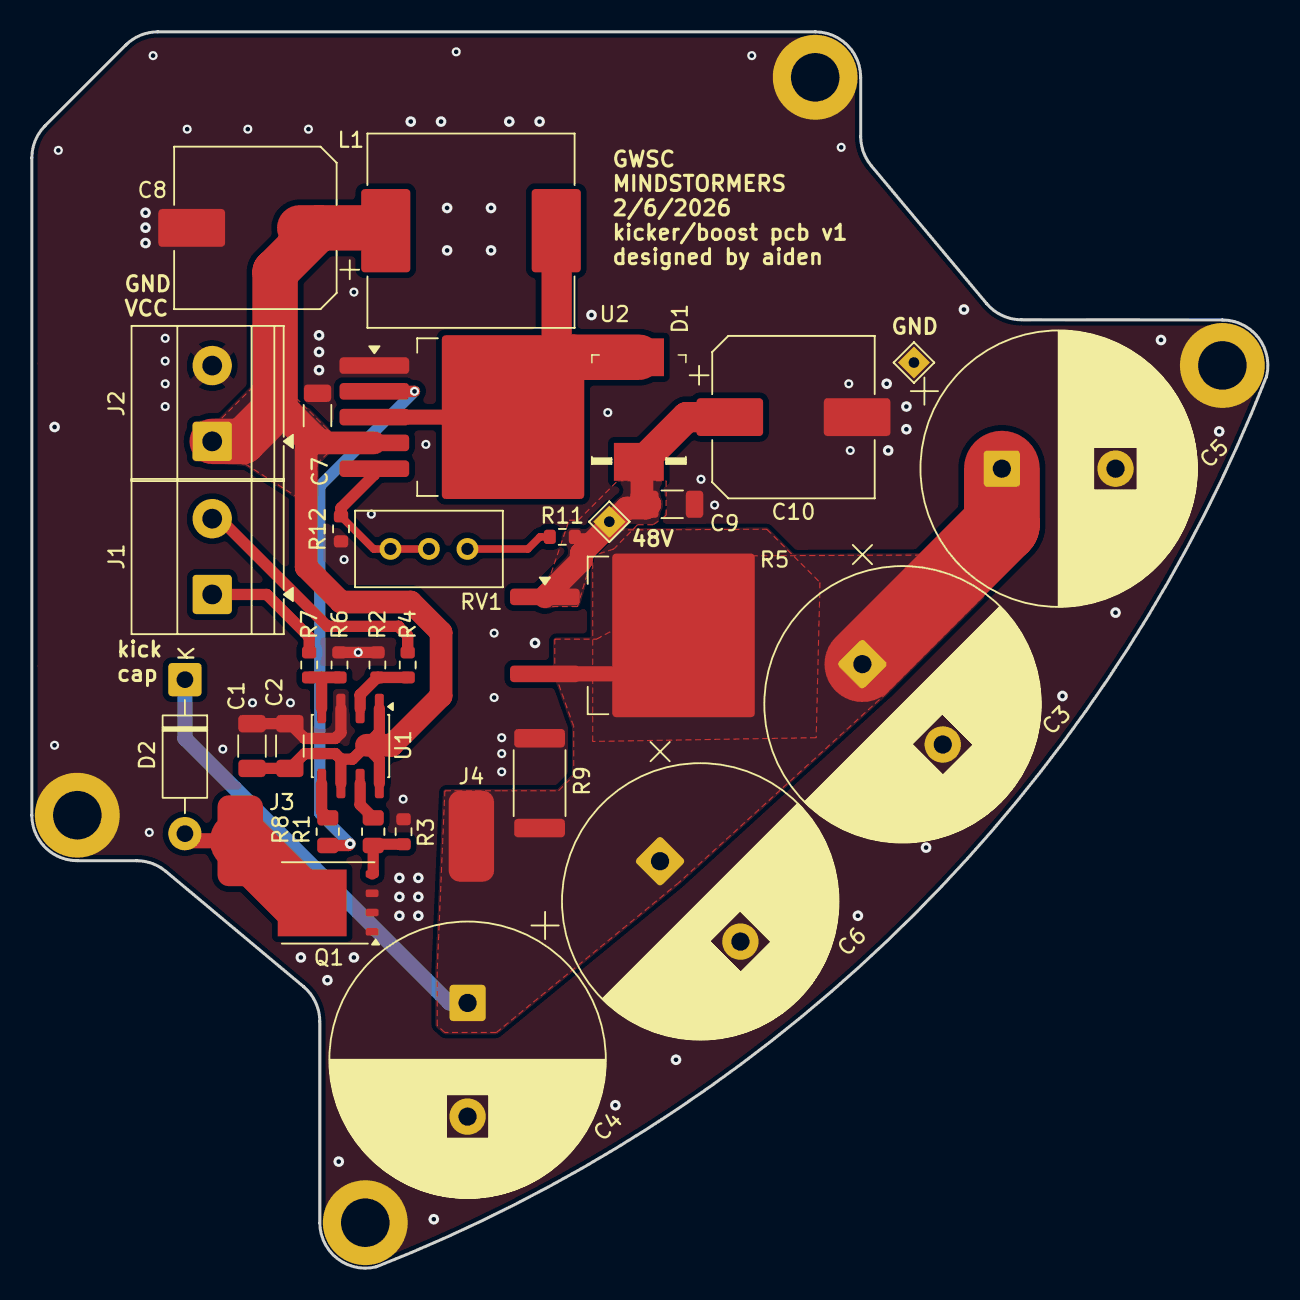
[picture p34: board kicker.kicad_pcb from above]

Board: 2 copper layers, 81.5 x 81.6 mm, 38 parts (0 on the bottom side), 16 nets.
