class-ab/open-soccer/PCBs/bottom/soccer bottom.kicad_pcb

## KiCad design PCBs/bottom/soccer bottom.kicad_pcb (2026-04-25)

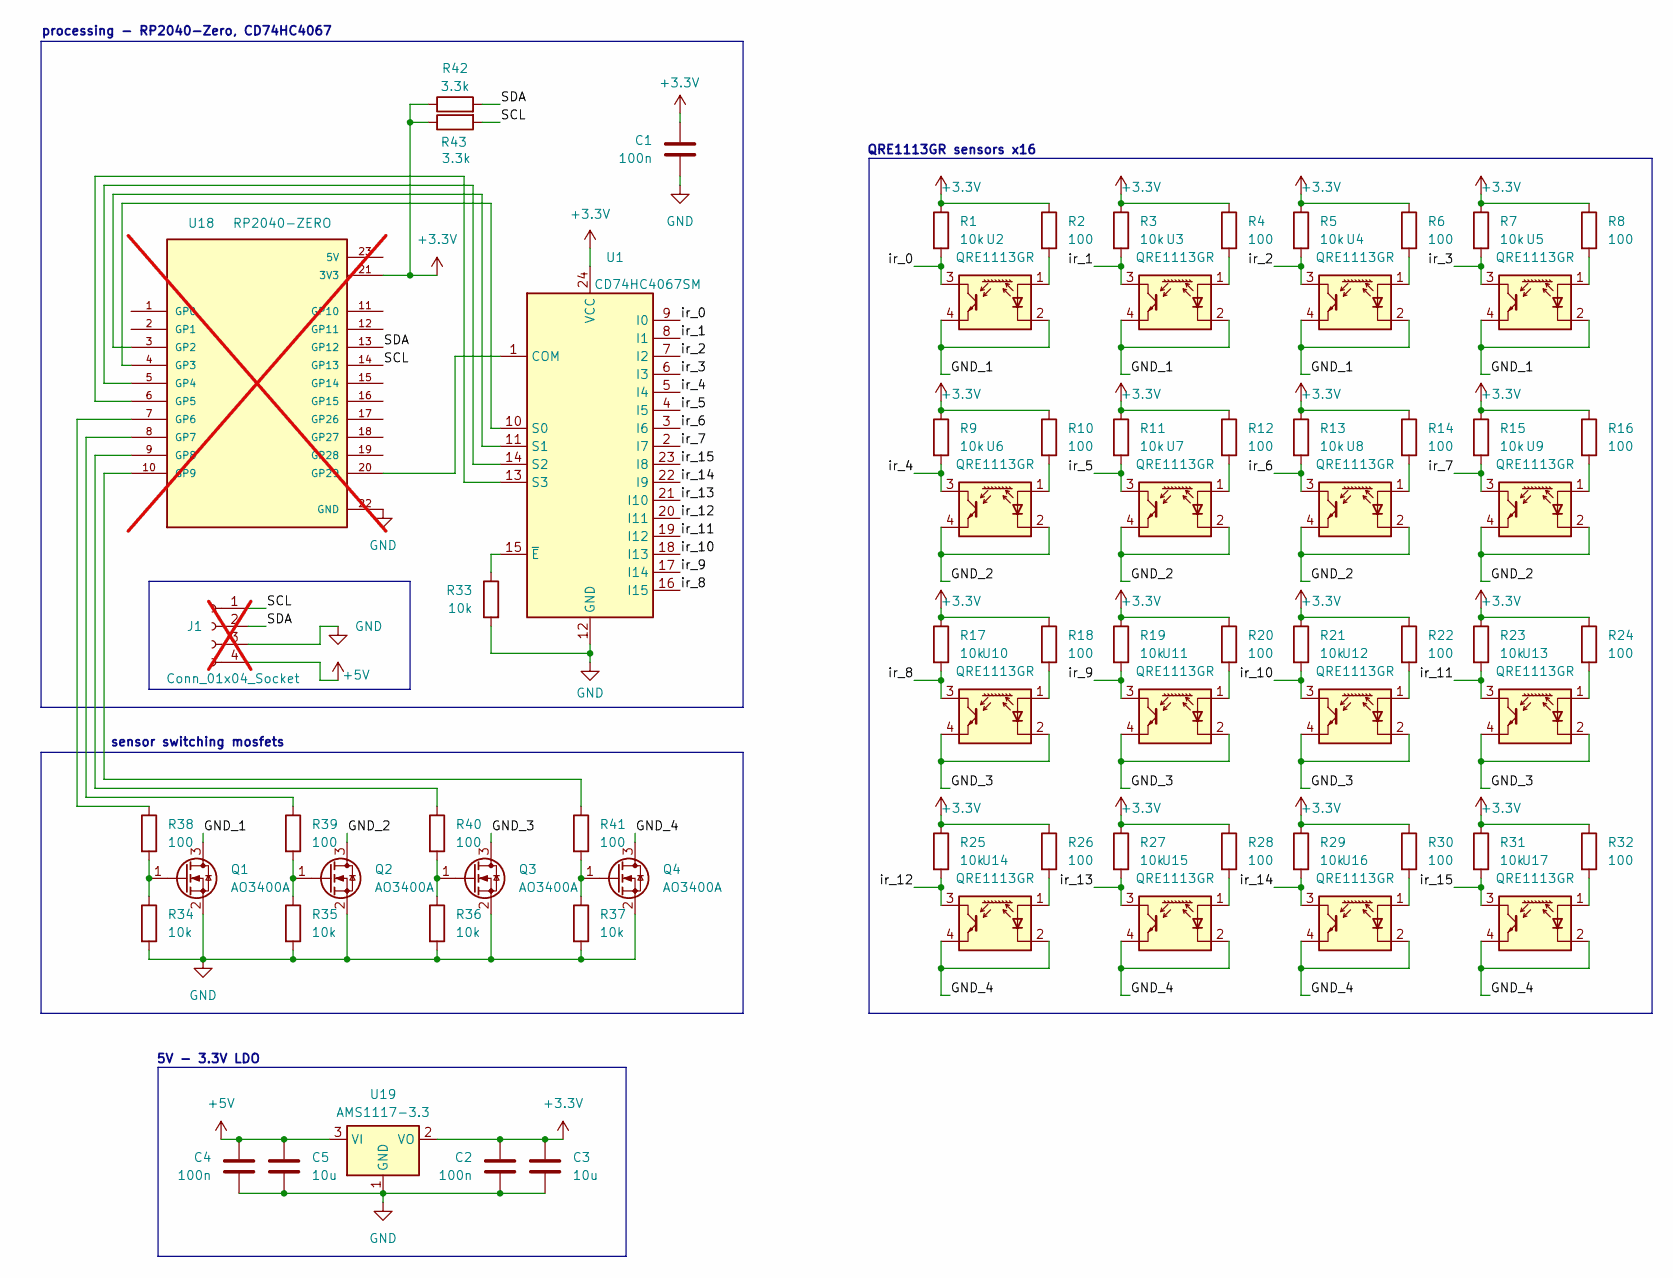
[picture p35: schematic soccer bottom.kicad_sch]

Parts:
C1, C2, C4: 100n; C_0805_2012Metric
C3, C5: 10u; C_0805_2012Metric
J1: Conn_01x04_Socket; JST_XH_B4B-XH-A_1x04_P2.50mm_Vertical; not fitted
Q1, Q2, Q3, Q4: AO3400A; SOT-23
R1, R3, R5, R7, R9, R11, R13, R15, R17, R19, R21, R23, R25, R27, R29, R31, R33, R34, R35, R36, R37: 10k; R_0805_2012Metric
R2, R4, R6, R8, R10, R12, R14, R16, R18, R20, R22, R24, R26, R28, R30, R32, R38, R39, R40, R41: 100; R_0805_2012Metric
R42, R43: 3.3k; R_0805_2012Metric
U1: CD74HC4067SM; SSOP-24_5.3x8.2mm_P0.65mm
U2, U3, U4, U5, U6, U7, U8, U9, U10, U11, U12, U13, U14, U15, U16, U17: QRE1113GR; OnSemi_CASE100CY
U18: RP2040-ZERO; MODULE_RP2040-ZERO; PARTREV NA; not fitted
U19: AMS1117-3.3; SOT-223-3_TabPin2

Connections:
+3.3V: C1.1, C2.1, C3.1, R1.1, R2.1, R3.1, R4.1, R5.1, R6.1, R7.1, R8.1, R9.1, R10.1, R11.1, R12.1, R13.1, R14.1, R15.1, R16.1, R17.1, R18.1, R19.1, R20.1, R21.1, R22.1, R23.1, R24.1, R25.1, R26.1, R27.1, R28.1, R29.1, R30.1, R31.1, R32.1, R42.1, R43.1, U1.24 (VCC), U18.21 (3V3), U19.2 (VO)
+5V: C4.1, C5.1, J1.4, U19.3 (VI)
/GND_1: Q1.3 (D), U2.2 (K), U2.4, U3.2 (K), U3.4, U4.2 (K), U4.4, U5.2 (K), U5.4
/GND_2: Q2.3 (D), U6.2 (K), U6.4, U7.2 (K), U7.4, U8.2 (K), U8.4, U9.2 (K), U9.4
/GND_3: Q3.3 (D), U10.2 (K), U10.4, U11.2 (K), U11.4, U12.2 (K), U12.4, U13.2 (K), U13.4
/GND_4: Q4.3 (D), U14.2 (K), U14.4, U15.2 (K), U15.4, U16.2 (K), U16.4, U17.2 (K), U17.4
/SCL: J1.1, R43.2, U18.14 (GP13)
/SDA: J1.2, R42.2, U18.13 (GP12)
/ir_0: R1.2, U1.9 (I0), U2.3
/ir_1: R3.2, U1.8 (I1), U3.3
/ir_2: R5.2, U1.7 (I2), U4.3
/ir_3: R7.2, U1.6 (I3), U5.3
/ir_4: R9.2, U1.5 (I4), U6.3
/ir_5: R11.2, U1.4 (I5), U7.3
/ir_6: R13.2, U1.3 (I6), U8.3
/ir_7: R15.2, U1.2 (I7), U9.3
/ir_8: R17.2, U1.16 (I15), U10.3
/ir_9: R19.2, U1.17 (I14), U11.3
/ir_10: R21.2, U1.18 (I13), U12.3
/ir_11: R23.2, U1.19 (I12), U13.3
/ir_12: R25.2, U1.20 (I11), U14.3
/ir_13: R27.2, U1.21 (I10), U15.3
/ir_14: R29.2, U1.22 (I9), U16.3
/ir_15: R31.2, U1.23 (I8), U17.3
GND: C1.2, C2.2, C3.2, C4.2, C5.2, J1.3, Q1.2 (S), Q2.2 (S), Q3.2 (S), Q4.2 (S), R33.2, R34.2, R35.2, R36.2, R37.2, U1.12 (GND), U18.22 (GND), U19.1 (GND)
unnamed: Q1.1 (G), R34.1, R38.2
unnamed: Q2.1 (G), R35.1, R39.2
unnamed: Q3.1 (G), R36.1, R40.2
unnamed: Q4.1 (G), R37.1, R41.2
unnamed: U1.1 (COM), U18.20 (GP29)
unnamed: U1.10 (S0), U18.4 (GP3)
unnamed: U1.11 (S1), U18.3 (GP2)
unnamed: U1.14 (S2), U18.5 (GP4)
unnamed: U1.13 (S3), U18.6 (GP5)
unnamed: R33.1, U1.15 (~E)
unnamed: R2.2, U2.1 (A)
unnamed: R4.2, U3.1 (A)
unnamed: R6.2, U4.1 (A)
unnamed: R8.2, U5.1 (A)
unnamed: R10.2, U6.1 (A)
unnamed: R12.2, U7.1 (A)
unnamed: R14.2, U8.1 (A)
unnamed: R16.2, U9.1 (A)
unnamed: R18.2, U10.1 (A)
unnamed: R20.2, U11.1 (A)
unnamed: R22.2, U12.1 (A)
unnamed: R24.2, U13.1 (A)
unnamed: R26.2, U14.1 (A)
unnamed: R28.2, U15.1 (A)
unnamed: R30.2, U16.1 (A)
unnamed: R32.2, U17.1 (A)
unnamed: R38.1, U18.7 (GP6)
unnamed: R39.1, U18.8 (GP7)
unnamed: R40.1, U18.9 (GP8)
unnamed: R41.1, U18.10 (GP9)

Notes on the sheet:
5V - 3.3V LDO
QRE1113GR sensors x16
processing - RP2040-Zero, CD74HC4067
sensor switching mosfets

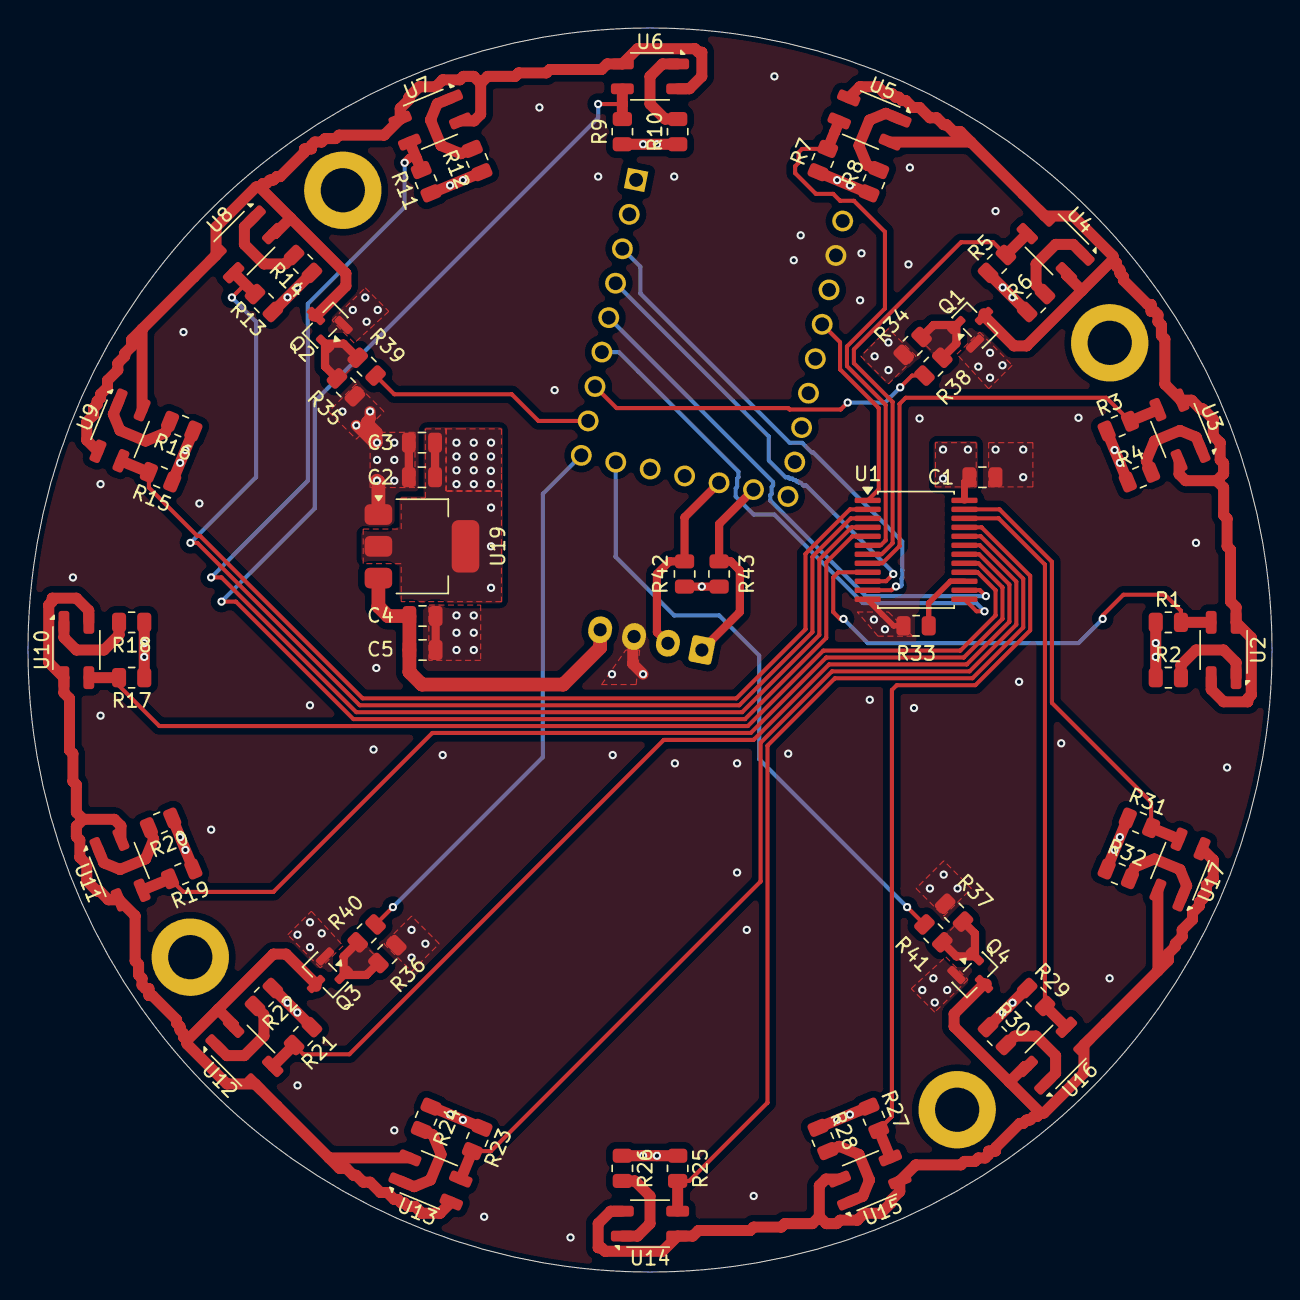
[picture p36: board soccer bottom.kicad_pcb from above]

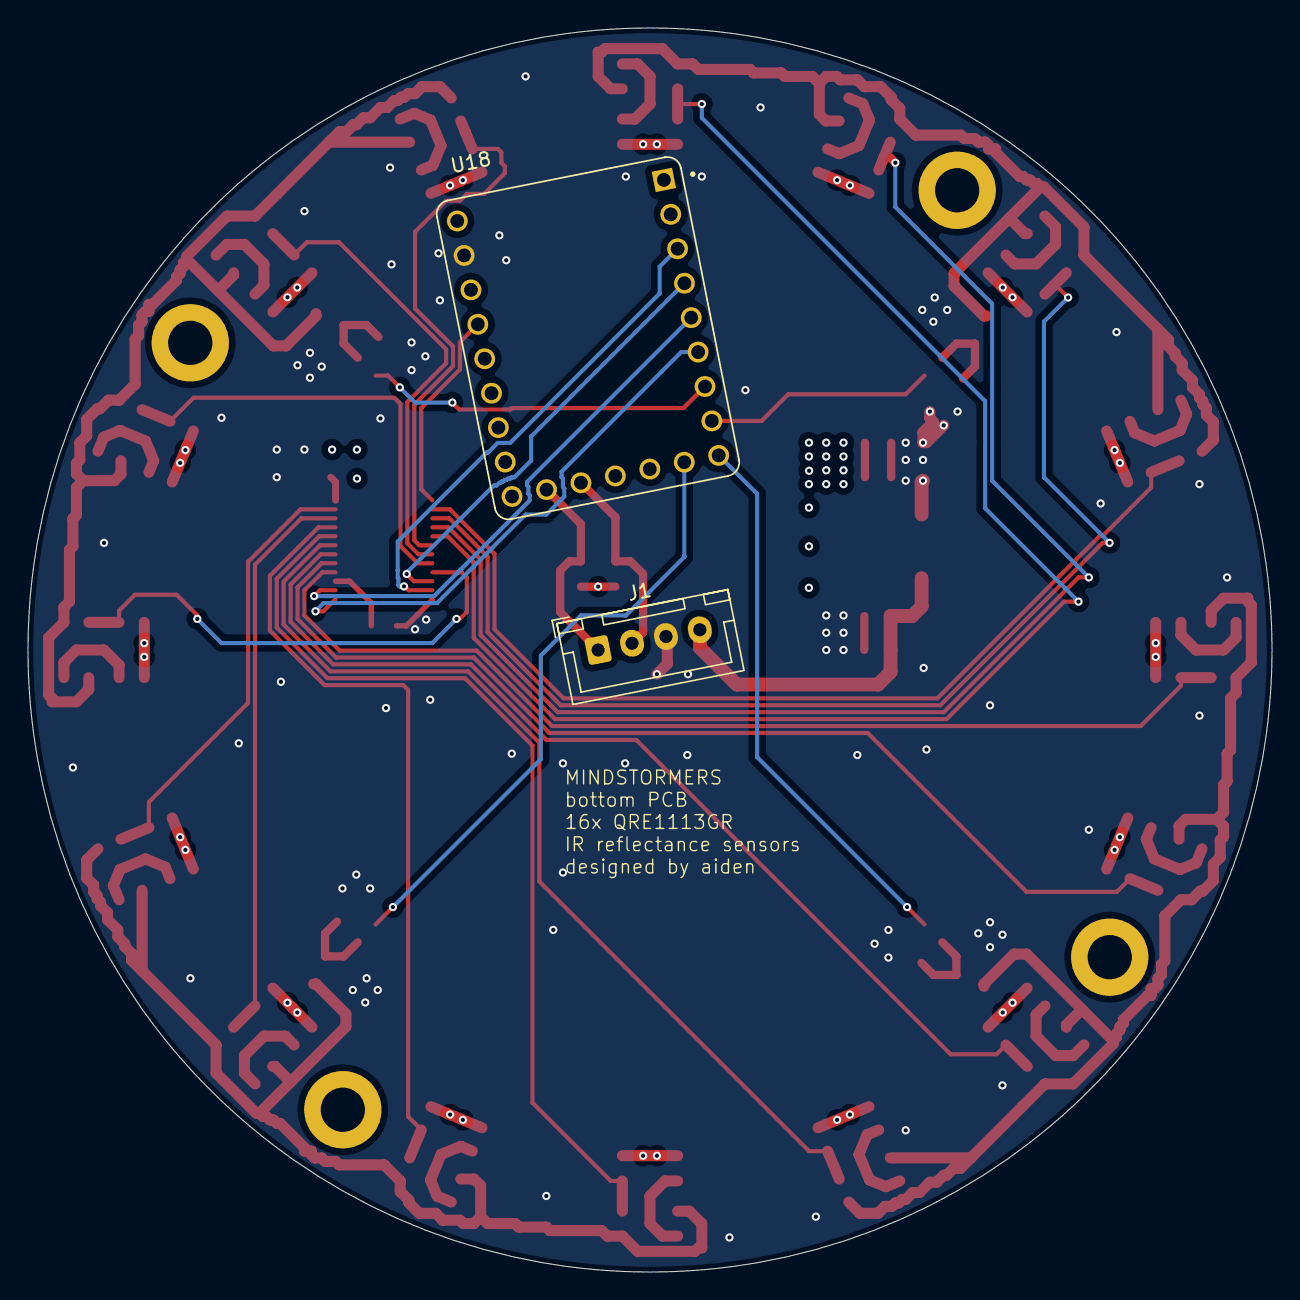
[picture p37: board soccer bottom.kicad_pcb from below]

Board: 4 copper layers, 90.0 x 90.0 mm, 72 parts (2 on the bottom side), 55 nets.
