class-ab/open-soccer/software/simulation/src/main.cpp

#include <SFML/Graphics.hpp>
#include <cmath>
#include <string>
#include <algorithm>
#include <array>
#include <iostream>

#include "subsystems/robot_state.h"
#include "subsystems/localization.h"
#include "subsystems/robot_config.h"
#include "subsystems/strategy.h"
#include "sim_hal/sim_robot_io.h"

// Simple 2D RCJ Open Soccer simulation
// - Units in this file are millimetres (mm) for field/robot constants
// - The graphics scale converts mm -> pixels (PX_PER_MM)

// Field geometry matches the robot localization map.
constexpr float FIELD_WIDTH_MM = 2430.0f;   // x dimension (mm)
constexpr float FIELD_HEIGHT_MM = 1820.0f;  // y dimension (mm)
constexpr float WHITE_LINE_THICKNESS_MM = 50.0f;
constexpr float WHITE_LINE_INSET_FROM_WALL_MM = 250.0f; // distance from outer wall to the white line
constexpr float GOAL_WIDTH_MM = 450.0f;
constexpr float GOAL_DEPTH_MM = 74.0f; // how far the goal extends inward (visual)

// Robot (configurable)
constexpr float ROBOT_DIAMETER_MM = 220.0f; // robot diameter
constexpr float DRIBBLER_WIDTH_MM = 40.0f;  // frontal dribbler width
constexpr float DRIBBLER_DEPTH_MM = 12.0f;  // how far it projects

// Ball (40 mm diameter golf-ball sized)
constexpr float BALL_DIAMETER_MM = 40.0f;
constexpr float BALL_RADIUS_MM = BALL_DIAMETER_MM / 2.0f;

// Ball physics tuning (units: mm, mm/s, seconds)
constexpr float BALL_FRICTION_PER_S = 2.0f;   // exponential rolling-decay coefficient (1/s)
constexpr float BALL_WALL_RESTITUTION = 0.6f; // fraction of speed kept when bouncing off walls/goals
constexpr float BALL_MAX_SPEED_MM_S = 5000.0f; // safety cap: prevents tunneling through goal boxes
constexpr float ROBOT_PUSH_FACTOR = 0.65f;    // fraction of the robot's closing speed imparted to the ball

// Rendering
float PX_PER_MM = 0.35f; // default scale (pixels per millimetre). Adjust for window size.
const int WINDOW_MARGIN_PX = 40;
const int HUD_PANEL_WIDTH_PX = 320; // fixed HUD panel width on the right side

// Helper conversions
inline float mmToPx(float mm) { return mm * PX_PER_MM; }

struct AxisAlignedRect {
    float left;
    float top;
    float width;
    float height;
};

// Goals are solid rectangular obstacles in simulation coordinates. Keeping
// these bounds in millimetres makes their collision independent of rendering
// scale and matches the rectangles drawn later in main().
const AxisAlignedRect LEFT_GOAL_BOUNDS = {
    WHITE_LINE_INSET_FROM_WALL_MM + WHITE_LINE_THICKNESS_MM / 2.0f - GOAL_DEPTH_MM,
    (FIELD_HEIGHT_MM - GOAL_WIDTH_MM) / 2.0f,
    GOAL_DEPTH_MM,
    GOAL_WIDTH_MM
};
const AxisAlignedRect RIGHT_GOAL_BOUNDS = {
    FIELD_WIDTH_MM - WHITE_LINE_INSET_FROM_WALL_MM - WHITE_LINE_THICKNESS_MM / 2.0f,
    (FIELD_HEIGHT_MM - GOAL_WIDTH_MM) / 2.0f,
    GOAL_DEPTH_MM,
    GOAL_WIDTH_MM
};

float clampFloat(float value, float minimum, float maximum) {
    return std::max(minimum, std::min(maximum, value));
}

void resolveCircleAgainstRect(sf::Vector2f& position, float radius, const AxisAlignedRect& rect) {
    const float right = rect.left + rect.width;
    const float bottom = rect.top + rect.height;
    const float closestX = clampFloat(position.x, rect.left, right);
    const float closestY = clampFloat(position.y, rect.top, bottom);
    const float dx = position.x - closestX;
    const float dy = position.y - closestY;
    const float distanceSquared = dx * dx + dy * dy;

    if (distanceSquared >= radius * radius) {
        return;
    }

    if (distanceSquared > 0.0001f) {
        const float distance = std::sqrt(distanceSquared);
        const float pushDistance = radius - distance;
        position.x += dx / distance * pushDistance;
        position.y += dy / distance * pushDistance;
        return;
    }

    // The circle centre is inside the goal. Push it through its nearest face.
    const float toLeft = position.x - rect.left;
    const float toRight = right - position.x;
    const float toTop = position.y - rect.top;
    const float toBottom = bottom - position.y;
    const float nearestFace = std::min(std::min(toLeft, toRight), std::min(toTop, toBottom));

    if (nearestFace == toLeft) position.x = rect.left - radius;
    else if (nearestFace == toRight) position.x = right + radius;
    else if (nearestFace == toTop) position.y = rect.top - radius;
    else position.y = bottom + radius;
}

void constrainToFieldAndGoals(sf::Vector2f& position, float radius) {
    position.x = clampFloat(position.x, radius, FIELD_WIDTH_MM - radius);
    position.y = clampFloat(position.y, radius, FIELD_HEIGHT_MM - radius);
    resolveCircleAgainstRect(position, radius, LEFT_GOAL_BOUNDS);
    resolveCircleAgainstRect(position, radius, RIGHT_GOAL_BOUNDS);
}

void moveWithGoalCollision(sf::Vector2f& position, const sf::Vector2f& target, float radius) {
    const sf::Vector2f delta = target - position;
    const float distance = std::sqrt(delta.x * delta.x + delta.y * delta.y);
    // Sweep in short increments so a fast robot or mouse drag cannot step
    // completely through a shallow goal in one frame.
    const int steps = std::max(1, static_cast<int>(std::ceil(distance / std::max(1.0f, radius * 0.5f))));
    const sf::Vector2f step = delta / static_cast<float>(steps);

    for (int i = 0; i < steps; ++i) {
        position += step;
        constrainToFieldAndGoals(position, radius);
    }
}

// Ball position is only ever clamped to the field walls. Dragging/dropping the
// ball must place it exactly where the cursor is (even over/behind a goal);
// goal collisions only apply to the ball while it is rolling (moveBall below).
void clampBallToField(sf::Vector2f& position) {
    position.x = clampFloat(position.x, BALL_RADIUS_MM, FIELD_WIDTH_MM - BALL_RADIUS_MM);
    position.y = clampFloat(position.y, BALL_RADIUS_MM, FIELD_HEIGHT_MM - BALL_RADIUS_MM);
}

// Ball drag: follow the mouse exactly (clamped to the field walls). No goal
// collision here, so the ball never snaps to a goal surface while dragging.
void moveBallWithCollision(sf::Vector2f& position, const sf::Vector2f& target) {
    position = target;
    clampBallToField(position);
}

// Keep the ball out of the goal boxes themselves (no scoring possible yet):
// if the ball's centre is ever inside a goal box (e.g. shoved over the mouth
// by the robot), return it to that goal's mouth. This is called only from the
// physics step, never while the user is dragging, so it cannot snap a ball to
// the goal surface as it is being dropped in the open field.
void containBallInGoalBoxes(sf::Vector2f& position) {
    if (position.x > LEFT_GOAL_BOUNDS.left && position.x < LEFT_GOAL_BOUNDS.left + LEFT_GOAL_BOUNDS.width &&
        position.y > LEFT_GOAL_BOUNDS.top && position.y < LEFT_GOAL_BOUNDS.top + LEFT_GOAL_BOUNDS.height) {
        position.x = LEFT_GOAL_BOUNDS.left + LEFT_GOAL_BOUNDS.width + BALL_RADIUS_MM;
    }
    if (position.x > RIGHT_GOAL_BOUNDS.left && position.x < RIGHT_GOAL_BOUNDS.left + RIGHT_GOAL_BOUNDS.width &&
        position.y > RIGHT_GOAL_BOUNDS.top && position.y < RIGHT_GOAL_BOUNDS.top + RIGHT_GOAL_BOUNDS.height) {
        position.x = RIGHT_GOAL_BOUNDS.left - BALL_RADIUS_MM;
    }
}

void resolveBallAgainstRect(sf::Vector2f& position, sf::Vector2f& velocity, const AxisAlignedRect& rect) {
    const float right = rect.left + rect.width;
    const float bottom = rect.top + rect.height;

    // Left face (ball just to the left of the face)
    if (position.x > rect.left - BALL_RADIUS_MM && position.x < rect.left &&
        position.y > rect.top && position.y < bottom) {
        position.x = rect.left - BALL_RADIUS_MM;
        velocity.x = std::abs(velocity.x) * BALL_WALL_RESTITUTION;
    }
    // Right face (ball just to the right of the face)
    if (position.x > right && position.x < right + BALL_RADIUS_MM &&
        position.y > rect.top && position.y < bottom) {
        position.x = right + BALL_RADIUS_MM;
        velocity.x = -std::abs(velocity.x) * BALL_WALL_RESTITUTION;
    }
    // Top face (ball just above the face)
    if (position.y > rect.top - BALL_RADIUS_MM && position.y < rect.top &&
        position.x > rect.left && position.x < right) {
        position.y = rect.top - BALL_RADIUS_MM;
        velocity.y = std::abs(velocity.y) * BALL_WALL_RESTITUTION;
    }
    // Bottom face (ball just below the face)
    if (position.y > bottom && position.y < bottom + BALL_RADIUS_MM &&
        position.x > rect.left && position.x < right) {
        position.y = bottom + BALL_RADIUS_MM;
        velocity.y = -std::abs(velocity.y) * BALL_WALL_RESTITUTION;
    }
}

void moveBall(sf::Vector2f& position, sf::Vector2f& velocity, float dt) {
    // Rolling friction
    velocity *= std::exp(-BALL_FRICTION_PER_S * dt);

    // Safety cap so an extreme robot push (high moveSpeedScale) cannot launch
    // the ball fast enough to skip past the goal boxes in one frame.
    const float speed = std::sqrt(velocity.x * velocity.x + velocity.y * velocity.y);
    if (speed > BALL_MAX_SPEED_MM_S) {
        velocity *= BALL_MAX_SPEED_MM_S / speed;
    }

    // Sweep in short increments (same idea as moveWithGoalCollision) so a fast
    // ball bounces off walls/goals instead of tunnelling straight through the
    // shallow goal boxes.
    const float maxStepDist = BALL_RADIUS_MM * 0.5f;
    float remaining = dt;
    while (remaining > 0.0f) {
        const float currentSpeed = std::sqrt(velocity.x * velocity.x + velocity.y * velocity.y);
        float stepTime = remaining;
        if (currentSpeed > 0.0001f) {
            stepTime = std::min(remaining, maxStepDist / currentSpeed);
        }
        position += velocity * stepTime;
        remaining -= stepTime;

        // Outer walls (reflect velocity, keeping a bit of energy)
        if (position.x < BALL_RADIUS_MM) {
            position.x = BALL_RADIUS_MM;
            velocity.x = std::abs(velocity.x) * BALL_WALL_RESTITUTION;
        } else if (position.x > FIELD_WIDTH_MM - BALL_RADIUS_MM) {
            position.x = FIELD_WIDTH_MM - BALL_RADIUS_MM;
            velocity.x = -std::abs(velocity.x) * BALL_WALL_RESTITUTION;
        }
        if (position.y < BALL_RADIUS_MM) {
            position.y = BALL_RADIUS_MM;
            velocity.y = std::abs(velocity.y) * BALL_WALL_RESTITUTION;
        } else if (position.y > FIELD_HEIGHT_MM - BALL_RADIUS_MM) {
            position.y = FIELD_HEIGHT_MM - BALL_RADIUS_MM;
            velocity.y = -std::abs(velocity.y) * BALL_WALL_RESTITUTION;
        }

        // Goals (treated as solid boxes, consistent with the robot)
        resolveBallAgainstRect(position, velocity, LEFT_GOAL_BOUNDS);
        resolveBallAgainstRect(position, velocity, RIGHT_GOAL_BOUNDS);
    }
}

// Dribbler physics: when the robot code requests the dribbler (dribblerShouldRun)
// and the ball touches the frontal dribbler bar, hold the ball against the bar
// so it moves and rotates with the robot. Once held, the ball stays held (re-
// pinned to the bar every frame) until the dribbler is switched off or the user
// grabs the ball. Returns true while the ball is held; the caller should then
// skip rolling/robot-body ball physics.
bool updateBallDribbling(sf::Vector2f& ballPosMm, sf::Vector2f& ballVelMmS,
                         bool ballHeld,
                         const sf::Vector2f& robotPos, float robotDiameterMm,
                         float headingDeg, const sf::Vector2f& robotVelMmS,
                         bool dribblerShouldRun) {
    if (!dribblerShouldRun) {
        return false;
    }
    const float radius = robotDiameterMm * 0.5f;
    // Dribbler bar centre sits just past the front of the robot body
    // (matches how the dribbler is drawn in Robot::draw).
    const float barCenterOffset = radius + 1.0f + DRIBBLER_DEPTH_MM * 0.5f;
    const float halfDepth = DRIBBLER_DEPTH_MM * 0.5f;
    const float halfWidth = DRIBBLER_WIDTH_MM * 0.5f;

    // Firmware heading uses +X as zero; screen Y is inverted.
    const float angleRad = -headingDeg * 3.14159265f / 180.0f;
    const sf::Vector2f frontVec(std::cos(angleRad), std::sin(angleRad));

    // Ball position relative to the robot, in the dribbler bar's local frame
    const sf::Vector2f toBall = ballPosMm - robotPos;
    const float forward = toBall.x * frontVec.x + toBall.y * frontVec.y;
    const float lateral = std::abs(toBall.x * frontVec.y - toBall.y * frontVec.x);
    const float u = forward - barCenterOffset;

    // The ball touches the bar when its centre is within a ball radius of the
    // bar rectangle (front face, or the side edges as it is scooped up).
    const bool touchesBar =
        std::abs(u) <= halfDepth + BALL_RADIUS_MM &&
        lateral <= halfWidth + BALL_RADIUS_MM;
    if (!ballHeld && !touchesBar) {
        return false;
    }

    // Hold the ball against the front of the bar and carry the robot's motion
    // over so a released ball keeps rolling naturally.
    ballVelMmS = robotVelMmS;
    ballPosMm = robotPos + frontVec * (barCenterOffset + halfDepth + BALL_RADIUS_MM);
    return true;
}

// The robot is far heavier than the ball, so on contact the ball is pushed out
// of the overlap and picks up a fraction of the robot's closing speed.
void resolveRobotBallCollision(sf::Vector2f& ballPos, sf::Vector2f& ballVel,
                               const sf::Vector2f& robotPos, float robotRadius,
                               const sf::Vector2f& robotVel) {
    const float minDist = robotRadius + BALL_RADIUS_MM;
    const sf::Vector2f toBall = ballPos - robotPos;
    const float distSq = toBall.x * toBall.x + toBall.y * toBall.y;
    if (distSq >= minDist * minDist) {
        return;
    }

    const float dist = std::sqrt(distSq);
    sf::Vector2f normal(0.0f, -1.0f);
    if (dist > 0.0001f) {
        normal = toBall / dist;
    }

    // Push the ball out to the robot's edge so they never overlap
    ballPos = robotPos + normal * minDist;

    // Only transfer momentum when the ball is approaching the robot
    const float relativeVelN = (ballVel.x - robotVel.x) * normal.x + (ballVel.y - robotVel.y) * normal.y;
    if (relativeVelN < 0.0f) {
        ballVel -= normal * (relativeVelN * ROBOT_PUSH_FACTOR);
    }
}

struct Robot {
    sf::Vector2f pos; // in mm
    float headingDeg; // 0 = right, matching the firmware field frame
    float diameterMm;

    Robot(): pos(FIELD_WIDTH_MM/2.0f, FIELD_HEIGHT_MM/2.0f), headingDeg(0.0f), diameterMm(ROBOT_DIAMETER_MM) {}

    void draw(sf::RenderTarget& rt) const {
        float r_px = mmToPx(diameterMm) / 2.0f;
        sf::CircleShape body(r_px);
        body.setOrigin(sf::Vector2f(r_px, r_px));
        body.setPosition(sf::Vector2f(mmToPx(pos.x) + WINDOW_MARGIN_PX, mmToPx(pos.y) + WINDOW_MARGIN_PX));
        body.setFillColor(sf::Color(200, 200, 220));
        body.setOutlineThickness(2.0f);
        body.setOutlineColor(sf::Color::Black);
        rt.draw(body);

        // draw heading indicator
        float angleRad = -headingDeg * 3.14159265f / 180.0f;
        sf::Vector2f dir(std::cos(angleRad), std::sin(angleRad));
        sf::VertexArray line(sf::PrimitiveType::Lines, 2);
        line[0].position = body.getPosition();
        line[0].color = sf::Color::Black;
        line[1].position = body.getPosition() + dir * (r_px * 1.1f);
        line[1].color = sf::Color::Red;
        rt.draw(line);

        // draw frontal dribbler as a small rectangle in front
        float dribblerW_px = mmToPx(DRIBBLER_WIDTH_MM);
        float dribblerD_px = mmToPx(DRIBBLER_DEPTH_MM);
        sf::RectangleShape drib(sf::Vector2f(dribblerW_px, dribblerD_px));
        drib.setOrigin(sf::Vector2f(dribblerW_px/2.0f, dribblerD_px));
        // position the dribbler at robot front
        sf::Vector2f front = body.getPosition() + dir * (r_px + dribblerD_px*0.5f + 1.0f);
        drib.setPosition(front);
        drib.setRotation(sf::degrees(90.0f - headingDeg));
        drib.setFillColor(sf::Color(120,120,120));
        rt.draw(drib);
    }
};

// Two robots are heavy enough that they should not pass through one another;
// push them apart symmetrically along the line between their centres.
void resolveRobotRobotCollision(Robot &a, Robot &b) {
    const sf::Vector2f delta = b.pos - a.pos;
    const float dist = std::sqrt(delta.x * delta.x + delta.y * delta.y);
    const float minDist = (a.diameterMm + b.diameterMm) / 2.0f;
    if (dist >= minDist || dist <= 0.0001f) {
        return;
    }
    const sf::Vector2f normal = delta / dist;
    const float overlap = minDist - dist;
    a.pos -= normal * (overlap * 0.5f);
    b.pos += normal * (overlap * 0.5f);
    constrainToFieldAndGoals(a.pos, a.diameterMm / 2.0f);
    constrainToFieldAndGoals(b.pos, b.diameterMm / 2.0f);
}

const char* robotStateName(RobotState state) {
    switch (state) {
        case RobotState::attacking: return "attacking";
        case RobotState::defending: return "defending";
        case RobotState::damaged: return "damaged";
    }
    return "unknown";
}

const char* robotGoalName(RobotGoal goal) {
    switch (goal) {
        case RobotGoal::none: return "none";
        case RobotGoal::getBallPush: return "getBallPush";
        case RobotGoal::getBallDribble: return "getBallDribble";
        case RobotGoal::getBallDribbleAway: return "getBallDribbleAway";
        case RobotGoal::interceptBall1: return "interceptBall1";
        case RobotGoal::interceptBall2: return "interceptBall2";
        case RobotGoal::pushForward: return "pushForward";
        case RobotGoal::hideForward: return "hideForward";
        case RobotGoal::spinKick: return "spinKick";
        case RobotGoal::kick: return "kick";
        case RobotGoal::pass: return "pass";
        case RobotGoal::awayBorders: return "awayBorders";
        case RobotGoal::backOff: return "backOff";
        case RobotGoal::defendBall: return "defendBall";
        case RobotGoal::defendOpponent1: return "defendOpponent1";
        case RobotGoal::defendOpponent2: return "defendOpponent2";
        case RobotGoal::searchBall: return "searchBall";
        case RobotGoal::dribbleForward: return "dribbleForward";
        case RobotGoal::hideBall: return "hideBall";
        case RobotGoal::scoring: return "scoring";
    }
    return "unknown";
}

// Per-robot simulator bookkeeping layered on top of the physical Robot body.
struct SimRobot {
    Robot robot;
    bool damaged = false;
    bool dragging = false;
    sf::Vector2f dragOffsetMm;
    LocalState publishedState{RobotState::attacking, RobotGoal::none};
};

// Draws a small state/goal label above a robot; skipped if no font loaded.
void drawRobotLabel(sf::RenderTarget &rt, const sf::Font &font, bool fontLoaded,
                    const Robot &robot, int robotNumber, const LocalState &state) {
    if (!fontLoaded) return;
    const std::string text = "R" + std::to_string(robotNumber) + ": " +
        robotStateName(state.robotState) + " / " + robotGoalName(state.robotGoal);
    sf::Text label(font, text, 13);
    label.setFillColor(sf::Color::White);
    label.setOutlineColor(sf::Color::Black);
    label.setOutlineThickness(2.0f);
    const float r_px = mmToPx(robot.diameterMm) / 2.0f;
    label.setPosition(sf::Vector2f(mmToPx(robot.pos.x) + WINDOW_MARGIN_PX - r_px,
                                  mmToPx(robot.pos.y) + WINDOW_MARGIN_PX - r_px - 20.0f));
    rt.draw(label);
}

int main() {
    // Compute an appropriate PX_PER_MM to maximize field size on the current screen while leaving a safety margin
    sf::VideoMode desktop = sf::VideoMode::getDesktopMode();
    unsigned int screenW = desktop.size.x;
    unsigned int screenH = desktop.size.y;
    const int EXTRA_MARGIN_W = 80; // extra safety margin beyond WINDOW_MARGIN_PX
    const int EXTRA_MARGIN_H = 100;
    // Reserve space horizontally for the HUD panel + an extra inner margin
    float reservedForHudPx = static_cast<float>(HUD_PANEL_WIDTH_PX + WINDOW_MARGIN_PX);
    float max_px_per_mm_w = float((int)screenW - 2*WINDOW_MARGIN_PX - EXTRA_MARGIN_W - (int)reservedForHudPx) / FIELD_WIDTH_MM;
    float max_px_per_mm_h = float((int)screenH - 2*WINDOW_MARGIN_PX - EXTRA_MARGIN_H) / FIELD_HEIGHT_MM;
    float chosen = std::min(max_px_per_mm_w, max_px_per_mm_h);
    // clamp to reasonable range
    PX_PER_MM = std::max(0.05f, std::min(chosen, 5.0f));

    // Compute window size in pixels from field dims using chosen scale.
    // Layout: [ left margin | field px | inner margin | HUD panel | right margin ]
    int winW = static_cast<int>(std::round(mmToPx(FIELD_WIDTH_MM))) + 3*WINDOW_MARGIN_PX + HUD_PANEL_WIDTH_PX;
    int winH = static_cast<int>(std::round(mmToPx(FIELD_HEIGHT_MM))) + 2*WINDOW_MARGIN_PX;

    sf::VideoMode mode(sf::Vector2u(static_cast<unsigned int>(winW), static_cast<unsigned int>(winH)), 32);
    sf::RenderWindow window(mode, sf::String("RCJ Open Soccer - 2D Simulation"));
    window.setFramerateLimit(60);

    std::cout << "Screen: " << screenW << "x" << screenH << ", PX_PER_MM=" << PX_PER_MM << "\n";

    // Two robots: index 0 starts as attacker, index 1 as defender.
    std::array<SimRobot, 2> sims;
    const sf::Vector2f INITIAL_POS[2] = {
        sf::Vector2f(FIELD_WIDTH_MM * 0.42f, FIELD_HEIGHT_MM * 0.5f),
        sf::Vector2f(FIELD_WIDTH_MM * 0.30f, FIELD_HEIGHT_MM * 0.5f)};
    sims[0].robot.pos = INITIAL_POS[0];
    sims[1].robot.pos = INITIAL_POS[1];

    // Create static shapes
    // full green area
    sf::RectangleShape greenBg(sf::Vector2f(mmToPx(FIELD_WIDTH_MM), mmToPx(FIELD_HEIGHT_MM)));
    greenBg.setPosition(sf::Vector2f(WINDOW_MARGIN_PX, WINDOW_MARGIN_PX));
    greenBg.setFillColor(sf::Color(50, 140, 60)); // green carpet
    greenBg.setOutlineThickness(2.0f);
    greenBg.setOutlineColor(sf::Color::Black);

    // walls (visual) - outer border drawn by margin+thin rects
    float outerW_px = mmToPx(FIELD_WIDTH_MM);
    float outerH_px = mmToPx(FIELD_HEIGHT_MM);

    // white lines (drawn as 4 rectangles inset by WHITE_LINE_INSET_FROM_WALL_MM)
    float inset_px = mmToPx(WHITE_LINE_INSET_FROM_WALL_MM);
    float lineThickness_px = mmToPx(WHITE_LINE_THICKNESS_MM);

    // top line rectangle
    sf::RectangleShape topLine(sf::Vector2f(outerW_px - 2*inset_px, lineThickness_px));
    topLine.setPosition(sf::Vector2f(WINDOW_MARGIN_PX + inset_px, WINDOW_MARGIN_PX + inset_px - lineThickness_px/2.0f));
    topLine.setFillColor(sf::Color::White);

    // bottom line
    sf::RectangleShape bottomLine(sf::Vector2f(outerW_px - 2*inset_px, lineThickness_px));
    bottomLine.setPosition(sf::Vector2f(WINDOW_MARGIN_PX + inset_px, WINDOW_MARGIN_PX + outerH_px - inset_px - lineThickness_px/2.0f));
    bottomLine.setFillColor(sf::Color::White);

    // left line
    sf::RectangleShape leftLine(sf::Vector2f(lineThickness_px, outerH_px - 2*inset_px));
    leftLine.setPosition(sf::Vector2f(WINDOW_MARGIN_PX + inset_px - lineThickness_px/2.0f, WINDOW_MARGIN_PX + inset_px));
    leftLine.setFillColor(sf::Color::White);

    // right line
    sf::RectangleShape rightLine(sf::Vector2f(lineThickness_px, outerH_px - 2*inset_px));
    rightLine.setPosition(sf::Vector2f(WINDOW_MARGIN_PX + outerW_px - inset_px - lineThickness_px/2.0f, WINDOW_MARGIN_PX + inset_px));
    rightLine.setFillColor(sf::Color::White);

    // Goals follow the firmware field map and sit on the short left/right ends.
    float goalW_px = mmToPx(GOAL_WIDTH_MM);
    float goalD_px = mmToPx(GOAL_DEPTH_MM);
    const float centerY_px = WINDOW_MARGIN_PX + outerH_px / 2.0f;
    const float leftGoalInnerX_px = WINDOW_MARGIN_PX + inset_px + lineThickness_px / 2.0f;
    const float rightGoalInnerX_px = WINDOW_MARGIN_PX + outerW_px - inset_px - lineThickness_px / 2.0f;
    sf::RectangleShape leftGoal(sf::Vector2f(goalD_px, goalW_px));
    leftGoal.setOrigin(sf::Vector2f(goalD_px, goalW_px / 2.0f));
    leftGoal.setPosition(sf::Vector2f(leftGoalInnerX_px, centerY_px));
    leftGoal.setFillColor(sf::Color(255, 255, 0));
    leftGoal.setOutlineThickness(2.0f);
    leftGoal.setOutlineColor(sf::Color::Black);

    sf::RectangleShape rightGoal(sf::Vector2f(goalD_px, goalW_px));
    rightGoal.setOrigin(sf::Vector2f(0.0f, goalW_px / 2.0f));
    rightGoal.setPosition(sf::Vector2f(rightGoalInnerX_px, centerY_px));
    rightGoal.setFillColor(sf::Color(0, 255, 255));
    rightGoal.setOutlineThickness(2.0f);
    rightGoal.setOutlineColor(sf::Color::Black);

    sf::Clock clock;

    // Robot/robotcode control
    bool robotEnabled = true; // initial state
    bool spacebarHeld = false;
    extern void robot_init(int index);
    extern void robot_stop(int index);
    extern void sim_step(unsigned long ms);

    // Start both robot code threads (each calls setup() then loop())
    robot_init(0);
    robot_init(1);
    sim_request_role(0, SimRoleCommand::attack);
    sim_request_role(1, SimRoleCommand::defend);

    // Ball entity
    sf::Vector2f ballPosMm(FIELD_WIDTH_MM * 0.5f, FIELD_HEIGHT_MM * 0.5f);
    sf::Vector2f ballVelMmS(0.0f, 0.0f); // ball velocity in mm/s (rolled/pushed around by physics)
    bool draggingBall = false;
    sf::Vector2f ballDragOffsetMm(0.f, 0.f);
    int ballHolderIndex = -1; // index of the robot currently holding the ball, or -1

    unsigned long simMs = 0;
    const unsigned long SIM_MS_PER_FRAME = 16; // ~60Hz sim time step (16ms)

    // Movement scaling controls (HUD adjustable)
    float moveSpeedScale = 1.0f;
    float rotSpeedScale = 1.0f;
    std::string moveSpeedStr = std::to_string(moveSpeedScale);
    std::string rotSpeedStr = std::to_string(rotSpeedScale);
    bool editMove = false;
    bool editRot = false;

    // Max physical speeds used by simulator (mm/s and deg/s)
    const float SIM_MAX_ROT_DEG_S = 300.0f;   // base max rotation speed

    while (window.isOpen()) {
        // Event handling (SFML3 uses std::optional<Event>)
        while (auto evOpt = window.pollEvent()) {
            const auto &ev = *evOpt;
            if (ev.is<sf::Event::Closed>()) {
                window.close();
            }
            if (ev.is<sf::Event::KeyPressed>()) {
                const auto *kp = ev.getIf<sf::Event::KeyPressed>();
                if (kp) {
                    if (kp->code == sf::Keyboard::Key::Escape) window.close();
                    if (kp->code == sf::Keyboard::Key::Space && !spacebarHeld) {
                        robotEnabled = !robotEnabled;
                        spacebarHeld = true;
                    }
                    if (kp->code == sf::Keyboard::Key::R) {
                        for (int i = 0; i < 2; ++i) {
                            sims[i].robot.pos = INITIAL_POS[i];
                            sims[i].robot.headingDeg = 0.0f;
                        }
                        ballPosMm = sf::Vector2f(FIELD_WIDTH_MM * 0.5f,
                                                 FIELD_HEIGHT_MM * 0.5f);
                        ballVelMmS = sf::Vector2f(0.0f, 0.0f);
                        ballHolderIndex = -1;
                    }
                    // Handle input editing keys
                    if (kp->code == sf::Keyboard::Key::Backspace) {
                        if (editMove && !moveSpeedStr.empty()) moveSpeedStr.pop_back();
                        if (editRot && !rotSpeedStr.empty()) rotSpeedStr.pop_back();
                    }
                    if (kp->code == sf::Keyboard::Key::Enter) {
                        if (editMove) {
                            try { moveSpeedScale = std::stof(moveSpeedStr); } catch(...) {}
                            editMove = false;
                        }
                        if (editRot) {
                            try { rotSpeedScale = std::stof(rotSpeedStr); } catch(...) {}
                            editRot = false;
                        }
                    }
                    if (kp->code == sf::Keyboard::Key::Escape) {
                        // cancel editing
                        if (editMove) { moveSpeedStr = std::to_string(moveSpeedScale); editMove = false; }
                        if (editRot) { rotSpeedStr = std::to_string(rotSpeedScale); editRot = false; }
                    }
                }
            }
            if (ev.is<sf::Event::KeyReleased>()) {
                const auto *kr = ev.getIf<sf::Event::KeyReleased>();
                if (kr && kr->code == sf::Keyboard::Key::Space) {
                    spacebarHeld = false;
                }
            }

            if (ev.is<sf::Event::TextEntered>()) {
                const auto *te = ev.getIf<sf::Event::TextEntered>();
                if (te) {
                    uint32_t uni = te->unicode;
                    // allow digits, dot, minus
                    if (uni == 8) { // backspace handled in KeyPressed, ignore
                    } else if (uni < 128) {
                        char c = static_cast<char>(uni);
                        if ((c >= '0' && c <= '9') || c == '.' || c == '-') {
                            if (editMove) moveSpeedStr.push_back(c);
                            if (editRot) rotSpeedStr.push_back(c);
                        }
                    }
                }
            }

            // Mouse: start dragging if left-click on robot or ball
            if (ev.is<sf::Event::MouseButtonPressed>()) {
                const auto *mb = ev.getIf<sf::Event::MouseButtonPressed>();
                if (mb && mb->button == sf::Mouse::Button::Left) {
                    sf::Vector2i pix = mb->position;
                    sf::Vector2f mouseMm((pix.x - WINDOW_MARGIN_PX) / PX_PER_MM, (pix.y - WINDOW_MARGIN_PX) / PX_PER_MM);

                    // check robots (skip damaged robots; they are removed from the field)
                    bool hitRobot = false;
                    for (int i = 0; i < 2 && !hitRobot; ++i) {
                        if (sims[i].damaged) continue;
                        float r_px = mmToPx(sims[i].robot.diameterMm) / 2.0f;
                        sf::Vector2f robotPx(mmToPx(sims[i].robot.pos.x) + WINDOW_MARGIN_PX, mmToPx(sims[i].robot.pos.y) + WINDOW_MARGIN_PX);
                        float rdx = float(pix.x) - robotPx.x;
                        float rdy = float(pix.y) - robotPx.y;
                        if (std::sqrt(rdx*rdx + rdy*rdy) <= r_px) {
                            sims[i].dragging = true;
                            sims[i].dragOffsetMm = sims[i].robot.pos - mouseMm; // preserve relative offset
                            hitRobot = true;
                        }
                    }
                    if (hitRobot) continue;

                    // check ball
                    float b_px = mmToPx(BALL_DIAMETER_MM) / 2.0f;
                    sf::Vector2f ballPx(mmToPx(ballPosMm.x) + WINDOW_MARGIN_PX, mmToPx(ballPosMm.y) + WINDOW_MARGIN_PX);
                    float bdx = float(pix.x) - ballPx.x;
                    float bdy = float(pix.y) - ballPx.y;
                    if (std::sqrt(bdx*bdx + bdy*bdy) <= b_px) {
                        draggingBall = true;
                        ballDragOffsetMm = ballPosMm - mouseMm;
                        ballVelMmS = sf::Vector2f(0.0f, 0.0f); // release a still ball
                        ballHolderIndex = -1; // user grabbed the ball off the dribbler
                            continue;
                        }

                        // HUD click area
                        float hudX_click = WINDOW_MARGIN_PX + mmToPx(FIELD_WIDTH_MM) + WINDOW_MARGIN_PX;
                        float hudY_click = WINDOW_MARGIN_PX;
                        const float pad_click = 10.0f;
                        const float btnSize = 28.0f;

                        // Scale control positions (match drawing below)
                        float scaleRowY = hudY_click + pad_click + 40.0f;
                        float moveInputX = hudX_click + pad_click + 160.0f; // x of input box
                        float moveInputW = 80.0f;
                        float moveInputH = 28.0f;

                        float rotInputX = hudX_click + pad_click + 160.0f;
                        float rotRowY = scaleRowY + 40.0f;
                        float rotInputW = 80.0f;
                        float rotInputH = 28.0f;

                        // Click on move input box
                        if (pix.x >= static_cast<int>(std::round(moveInputX)) && pix.x <= static_cast<int>(std::round(moveInputX + moveInputW)) && pix.y >= static_cast<int>(std::round(scaleRowY)) && pix.y <= static_cast<int>(std::round(scaleRowY + moveInputH))) {
                            editMove = true;
                            editRot = false;
                            // store current string
                            moveSpeedStr = std::to_string(moveSpeedScale);
                            continue;
                        }

                        // Click on rot input box
                        if (pix.x >= static_cast<int>(std::round(rotInputX)) && pix.x <= static_cast<int>(std::round(rotInputX + rotInputW)) && pix.y >= static_cast<int>(std::round(rotRowY)) && pix.y <= static_cast<int>(std::round(rotRowY + rotInputH))) {
                            editRot = true;
                            editMove = false;
                            rotSpeedStr = std::to_string(rotSpeedScale);
                            continue;
                        }

                        // check HUD enable/disable buttons (top-left of HUD panel)
                        const float ex = hudX_click + pad_click;
                        const float ey = hudY_click + pad_click;
                        const float dx = hudX_click + pad_click + 36.0f;
                        const float dy = ey;
                        if (pix.x >= static_cast<int>(std::round(ex)) && pix.x <= static_cast<int>(std::round(ex + btnSize)) && pix.y >= static_cast<int>(std::round(ey)) && pix.y <= static_cast<int>(std::round(ey + btnSize))) {
                            robotEnabled = true;
                            continue;
                        }
                        if (pix.x >= static_cast<int>(std::round(dx)) && pix.x <= static_cast<int>(std::round(dx + btnSize)) && pix.y >= static_cast<int>(std::round(dy)) && pix.y <= static_cast<int>(std::round(dy + btnSize))) {
                            robotEnabled = false;
                            continue;
                        }

                        // check per-robot role toggle buttons (Attack / Defend / Damaged)
                        bool hitRole = false;
                        for (int i = 0; i < 2 && !hitRole; ++i) {
                            const float sectionY = rotRowY + 40.0f + i * 90.0f;
                            const float buttonY = sectionY + 22.0f;
                            const float buttonW = 60.0f, buttonH = 24.0f;
                            const float atkX = hudX_click + pad_click;
                            const float defX = atkX + 70.0f;
                            const float dmgX = defX + 70.0f;
                            auto hitsButton = [&](float bx) {
                                return pix.x >= static_cast<int>(std::round(bx)) && pix.x <= static_cast<int>(std::round(bx + buttonW)) &&
                                       pix.y >= static_cast<int>(std::round(buttonY)) && pix.y <= static_cast<int>(std::round(buttonY + buttonH));
                            };
                            if (hitsButton(atkX)) {
                                sims[i].damaged = false;
                                sim_request_role(i, SimRoleCommand::attack);
                                hitRole = true;
                            } else if (hitsButton(defX)) {
                                sims[i].damaged = false;
                                sim_request_role(i, SimRoleCommand::defend);
                                hitRole = true;
                            } else if (hitsButton(dmgX)) {
                                sims[i].damaged = true;
                                sims[i].dragging = false;
                                if (ballHolderIndex == i) ballHolderIndex = -1;
                                sim_request_role(i, SimRoleCommand::damage);
                                hitRole = true;
                            }
                        }
                        if (hitRole) continue;
                    }
                }

            if (ev.is<sf::Event::MouseButtonReleased>()) {
                const auto *mb = ev.getIf<sf::Event::MouseButtonReleased>();
                if (mb && mb->button == sf::Mouse::Button::Left) {
                    for (int i = 0; i < 2; ++i) sims[i].dragging = false; // release control back to robot code
                    draggingBall = false;
                    ballVelMmS = sf::Vector2f(0.0f, 0.0f); // dropped ball must not roll off
                }
            }

            if (ev.is<sf::Event::MouseMoved>()) {
                const auto *mmv = ev.getIf<sf::Event::MouseMoved>();
                if (mmv) {
                    sf::Vector2i pix = mmv->position;
                    sf::Vector2f mouseMm((pix.x - WINDOW_MARGIN_PX) / PX_PER_MM, (pix.y - WINDOW_MARGIN_PX) / PX_PER_MM);
                    for (int i = 0; i < 2; ++i) {
                        if (sims[i].dragging) {
                            moveWithGoalCollision(sims[i].robot.pos, mouseMm + sims[i].dragOffsetMm, sims[i].robot.diameterMm / 2.0f);
                        }
                    }
                    if (draggingBall) {
                        moveBallWithCollision(ballPosMm, mouseMm + ballDragOffsetMm);
                    }
                }
            }
        }

        float dt = clock.restart().asSeconds();

        // Advance simulator time (fixed-step to keep deterministic behavior)
        simMs += SIM_MS_PER_FRAME;
        sim_step(simMs);

        // Clear and draw
        window.clear(sf::Color(60,60,60)); // background outside field

        // Recompute shapes that depend on scaling (if user zoomed)
        greenBg.setSize(sf::Vector2f(mmToPx(FIELD_WIDTH_MM), mmToPx(FIELD_HEIGHT_MM)));
        topLine.setSize(sf::Vector2f(mmToPx(FIELD_WIDTH_MM) - 2*mmToPx(WHITE_LINE_INSET_FROM_WALL_MM), mmToPx(WHITE_LINE_THICKNESS_MM)));
        topLine.setPosition(sf::Vector2f(WINDOW_MARGIN_PX + mmToPx(WHITE_LINE_INSET_FROM_WALL_MM), WINDOW_MARGIN_PX + mmToPx(WHITE_LINE_INSET_FROM_WALL_MM) - mmToPx(WHITE_LINE_THICKNESS_MM)/2.0f));
        bottomLine.setSize(topLine.getSize());
        bottomLine.setPosition(sf::Vector2f(WINDOW_MARGIN_PX + mmToPx(WHITE_LINE_INSET_FROM_WALL_MM), WINDOW_MARGIN_PX + mmToPx(FIELD_HEIGHT_MM) - mmToPx(WHITE_LINE_INSET_FROM_WALL_MM) - mmToPx(WHITE_LINE_THICKNESS_MM)/2.0f));
        leftLine.setSize(sf::Vector2f(mmToPx(WHITE_LINE_THICKNESS_MM), mmToPx(FIELD_HEIGHT_MM) - 2*mmToPx(WHITE_LINE_INSET_FROM_WALL_MM)));
        leftLine.setPosition(sf::Vector2f(WINDOW_MARGIN_PX + mmToPx(WHITE_LINE_INSET_FROM_WALL_MM) - mmToPx(WHITE_LINE_THICKNESS_MM)/2.0f, WINDOW_MARGIN_PX + mmToPx(WHITE_LINE_INSET_FROM_WALL_MM)));
        rightLine.setSize(leftLine.getSize());
        rightLine.setPosition(sf::Vector2f(WINDOW_MARGIN_PX + mmToPx(FIELD_WIDTH_MM) - mmToPx(WHITE_LINE_INSET_FROM_WALL_MM) - mmToPx(WHITE_LINE_THICKNESS_MM)/2.0f, WINDOW_MARGIN_PX + mmToPx(WHITE_LINE_INSET_FROM_WALL_MM)));

        // goals update
        goalW_px = mmToPx(GOAL_WIDTH_MM);
        goalD_px = mmToPx(GOAL_DEPTH_MM);
        const float currentCenterY_px = WINDOW_MARGIN_PX + mmToPx(FIELD_HEIGHT_MM) / 2.0f;
        const float leftInnerX_px = WINDOW_MARGIN_PX + mmToPx(WHITE_LINE_INSET_FROM_WALL_MM) + mmToPx(WHITE_LINE_THICKNESS_MM) / 2.0f;
        const float rightInnerX_px = WINDOW_MARGIN_PX + mmToPx(FIELD_WIDTH_MM) - mmToPx(WHITE_LINE_INSET_FROM_WALL_MM) - mmToPx(WHITE_LINE_THICKNESS_MM) / 2.0f;
        leftGoal.setSize(sf::Vector2f(goalD_px, goalW_px));
        leftGoal.setOrigin(sf::Vector2f(goalD_px, goalW_px / 2.0f));
        leftGoal.setPosition(sf::Vector2f(leftInnerX_px, currentCenterY_px));
        rightGoal.setSize(sf::Vector2f(goalD_px, goalW_px));
        rightGoal.setOrigin(sf::Vector2f(0.0f, goalW_px / 2.0f));
        rightGoal.setPosition(sf::Vector2f(rightInnerX_px, currentCenterY_px));

        // draw field
        window.draw(greenBg);
        window.draw(topLine);
        window.draw(bottomLine);
        window.draw(leftLine);
        window.draw(rightLine);

        // goals
        window.draw(leftGoal);
        window.draw(rightGoal);

        // Apply MoveProfile to simulated robot physics (if robot code is running and profile active)
        float dt_s = float(SIM_MS_PER_FRAME) / 1000.0f;
        sf::Vector2f prevRobotPos[2];
        float prevRobotHeading[2];
        MoveProfile moveProfiles[2] = {};
        bool dribblerFlags[2] = {false, false};
        for (int i = 0; i < 2; ++i) {
            prevRobotPos[i] = sims[i].robot.pos;
            prevRobotHeading[i] = sims[i].robot.headingDeg;
            sim_set_running(i, robotEnabled);
            if (sims[i].damaged) continue;
            bool dribble = false;
            sim_get_move_profile(i, moveProfiles[i], dribble);
            dribblerFlags[i] = dribble;
            if (robotEnabled && moveProfiles[i].active) {
                const float linear_mm_s = moveProfiles[i].speed * ROBOT_LINEAR_SPEED_MM_S * 0.9f * moveSpeedScale;
                const float rot_deg_s = moveProfiles[i].rotationSpeed / ROTATION_MAX_SPEED * SIM_MAX_ROT_DEG_S * rotSpeedScale;
                sims[i].robot.headingDeg += rot_deg_s * dt_s;
                const float angleRad = moveProfiles[i].movementDirectionDeg * 3.14159265f / 180.0f;
                float dx = std::cos(angleRad) * linear_mm_s * dt_s;
                float dy = -std::sin(angleRad) * linear_mm_s * dt_s;
                moveWithGoalCollision(sims[i].robot.pos, sims[i].robot.pos + sf::Vector2f(dx, dy), sims[i].robot.diameterMm / 2.0f);
            }
        }
        if (!sims[0].damaged && !sims[1].damaged) {
            resolveRobotRobotCollision(sims[0].robot, sims[1].robot);
        }

        // Ball physics: roll with friction, bounce off walls/goals, and be
        // pushed out (and given a nudge) whenever it touches a robot.
        // If a robot's dribbler is requested and the ball touches its frontal
        // dribbler bar, the ball is held against the bar instead of
        // rolling/bouncing, so it moves and rotates with that robot.
        sf::Vector2f robotVelMmS[2];
        for (int i = 0; i < 2; ++i) {
            robotVelMmS[i] = dt_s > 0.0f ? (sims[i].robot.pos - prevRobotPos[i]) / dt_s : sf::Vector2f(0.0f, 0.0f);
        }
        for (int i = 0; i < 2; ++i) {
            if (sims[i].damaged) continue;
            if (sim_consume_kick_request(i)) {
                const float angleRad = -sims[i].robot.headingDeg * 3.14159265f / 180.0f;
                const sf::Vector2f frontVec(std::cos(angleRad), std::sin(angleRad));
                const sf::Vector2f toBall = ballPosMm - sims[i].robot.pos;
                const float forwardDistance = toBall.x * frontVec.x + toBall.y * frontVec.y;
                const float lateralDistance = std::abs(toBall.x * frontVec.y - toBall.y * frontVec.x);
                if (forwardDistance > 0.0f &&
                    forwardDistance <= sims[i].robot.diameterMm / 2.0f + BALL_RADIUS_MM + 60.0f &&
                    lateralDistance <= sims[i].robot.diameterMm / 2.0f) {
                    ballHolderIndex = -1;
                    ballVelMmS = frontVec * 2500.0f + robotVelMmS[i];
                }
            }
        }
        if (!draggingBall) {
            if (ballHolderIndex != -1 && sims[ballHolderIndex].damaged) {
                ballHolderIndex = -1;
            }
            if (ballHolderIndex != -1) {
                const bool stillHeld = updateBallDribbling(
                    ballPosMm, ballVelMmS, true, sims[ballHolderIndex].robot.pos,
                    sims[ballHolderIndex].robot.diameterMm, sims[ballHolderIndex].robot.headingDeg,
                    robotVelMmS[ballHolderIndex], dribblerFlags[ballHolderIndex]);
                if (!stillHeld) ballHolderIndex = -1;
            } else {
                for (int i = 0; i < 2 && ballHolderIndex == -1; ++i) {
                    if (sims[i].damaged) continue;
                    const bool held = updateBallDribbling(
                        ballPosMm, ballVelMmS, false, sims[i].robot.pos, sims[i].robot.diameterMm,
                        sims[i].robot.headingDeg, robotVelMmS[i], dribblerFlags[i]);
                    if (held) ballHolderIndex = i;
                }
            }
        }
        // The user fully controls the ball while dragging it, so the robots must
        // not shove it around (or give it velocity) mid-drag.
        if (!draggingBall && ballHolderIndex == -1) {
            moveBall(ballPosMm, ballVelMmS, dt_s);
        }
        if (!draggingBall && ballHolderIndex == -1) {
            for (int i = 0; i < 2; ++i) {
                if (sims[i].damaged) continue;
                resolveRobotBallCollision(ballPosMm, ballVelMmS, sims[i].robot.pos, sims[i].robot.diameterMm / 2.0f, robotVelMmS[i]);
            }
        }
        if (!draggingBall) {
            containBallInGoalBoxes(ballPosMm);
        }
        clampBallToField(ballPosMm);

        // Ensure the HUD font is loaded before it is needed by on-field labels.
        static sf::Font hudFont;
        static bool hudFontLoaded = false;
        if (!hudFontLoaded) {
           // Try common Windows fonts as a fallback so HUD works without bundling a font file
           hudFontLoaded = hudFont.openFromFile("C:\\Windows\\Fonts\\arial.ttf")
               || hudFont.openFromFile("C:\\Windows\\Fonts\\segoeui.ttf")
               || hudFont.openFromFile("C:\\Windows\\Fonts\\tahoma.ttf");
        }

        // draw robots (damaged robots are removed from the field entirely)
        for (int i = 0; i < 2; ++i) {
            if (sims[i].damaged) continue;
            sims[i].robot.draw(window);
            drawRobotLabel(window, hudFont, hudFontLoaded, sims[i].robot, i + 1, sims[i].publishedState);
        }

        // draw ball
        float ball_r_px = mmToPx(BALL_DIAMETER_MM) / 2.0f;
        sf::CircleShape ballShape(ball_r_px);
        ballShape.setOrigin(sf::Vector2f(ball_r_px, ball_r_px));
        ballShape.setPosition(sf::Vector2f(mmToPx(ballPosMm.x) + WINDOW_MARGIN_PX, mmToPx(ballPosMm.y) + WINDOW_MARGIN_PX));
        ballShape.setFillColor(sf::Color(255, 165, 0)); // orange
        ballShape.setOutlineColor(sf::Color::Black);
        ballShape.setOutlineThickness(1.0f);
        window.draw(ballShape);

        // Update each robot's BallPacket/localization/IMU inputs based on ball->robot geometry
        float ballBearingDeg[2] = {0.0f, 0.0f};
        float ballDistCm[2] = {0.0f, 0.0f};
        for (int i = 0; i < 2; ++i) {
            float dx = ballPosMm.x - sims[i].robot.pos.x;
            float dy = ballPosMm.y - sims[i].robot.pos.y;
            float distMm = std::sqrt(dx*dx + dy*dy);
            // Robot front direction (world frame) as unit vector
            float angleRad = -sims[i].robot.headingDeg * 3.14159265f / 180.0f;
            sf::Vector2f frontVec(std::cos(angleRad), std::sin(angleRad));
            // vector to ball
            sf::Vector2f v(dx, dy);
            // compute signed angle between frontVec and v
            float dot = frontVec.x * v.x + frontVec.y * v.y;
            float cross = frontVec.x * v.y - frontVec.y * v.x;
            float bearingRad = std::atan2(cross, dot);
            float bearingDeg = bearingRad * 180.0f / 3.14159265f;
            ballBearingDeg[i] = bearingDeg;
            ballDistCm[i] = distMm / 10.0f;

            BallPacket packet;
            packet.detected = true;
            packet.angleDeg = bearingDeg; // angle relative to robot front
            packet.distanceCM = distMm / 10.0f;
            packet.sizeByte = static_cast<uint8_t>(std::min(255, static_cast<int>(BALL_DIAMETER_MM)));
            // Use simulator-driven milliseconds (simMs) so the robot firmware
            // (which reads millis()) sees a consistent epoch.
            sim_publish_ball_packet(i, packet, simMs);

            const RobotPose simulatedPose = {
                true,
                sims[i].robot.pos.x - FIELD_WIDTH_MM / 2.0f,
                FIELD_HEIGHT_MM / 2.0f - sims[i].robot.pos.y,
                sims[i].robot.headingDeg,
                1.0f,
                simMs};
            const FieldBall simulatedBall = {
                true,
                ballPosMm.x - FIELD_WIDTH_MM / 2.0f,
                FIELD_HEIGHT_MM / 2.0f - ballPosMm.y,
                distMm / 10.0f,
                bearingDeg,
                simMs};
            sim_set_localization(i, simulatedPose, simulatedBall, nullptr, 0);
            const float yawRateDegPerSec = dt_s > 0.0f
                ? (sims[i].robot.headingDeg - prevRobotHeading[i]) / dt_s
                : 0.0f;
            sim_set_imu_state(i, sims[i].robot.headingDeg, yawRateDegPerSec);
            sim_get_published_local_state(i, sims[i].publishedState);
        }

        float hudX = WINDOW_MARGIN_PX + mmToPx(FIELD_WIDTH_MM) + WINDOW_MARGIN_PX;
        float hudY = WINDOW_MARGIN_PX;
        float hudW = static_cast<float>(HUD_PANEL_WIDTH_PX);
        float hudH = mmToPx(FIELD_HEIGHT_MM);

        // draw HUD background panel
        sf::RectangleShape hudPanel(sf::Vector2f(hudW, hudH));
        hudPanel.setPosition(sf::Vector2f(hudX, hudY));
        hudPanel.setFillColor(sf::Color(30,30,30));
        hudPanel.setOutlineColor(sf::Color::Black);
        hudPanel.setOutlineThickness(2.0f);
        window.draw(hudPanel);

        // Ensure HUD font is available
        const float pad = 10.0f;

        // draw enable/disable buttons at top-left of HUD
        sf::RectangleShape btnEnable(sf::Vector2f(28.0f, 28.0f));
        btnEnable.setPosition(sf::Vector2f(hudX + pad, hudY + pad));
        btnEnable.setFillColor(robotEnabled ? sf::Color(50,200,50) : sf::Color(80,80,80));
        btnEnable.setOutlineThickness(1.0f);
        btnEnable.setOutlineColor(sf::Color::Black);
        window.draw(btnEnable);
 
        sf::RectangleShape btnDisable(sf::Vector2f(28.0f, 28.0f));
        btnDisable.setPosition(sf::Vector2f(hudX + pad + 36.0f, hudY + pad));
        btnDisable.setFillColor(!robotEnabled ? sf::Color(220,50,50) : sf::Color(80,80,80));
        btnDisable.setOutlineThickness(1.0f);
        btnDisable.setOutlineColor(sf::Color::Black);
        window.draw(btnDisable);

        // Draw labels for robot state
        if (hudFontLoaded) {
            sf::Text stateLabel(hudFont, robotEnabled ? "Robot: ENABLED" : "Robot: DISABLED", 14);
            stateLabel.setFillColor(robotEnabled ? sf::Color(180,255,180) : sf::Color(200,120,120));
            stateLabel.setPosition(sf::Vector2f(hudX + pad + 72.0f, hudY + pad + 4.0f));
            window.draw(stateLabel);
        }

        float rotY = 0.0f;

        // Draw MoveProfile scaling controls
        if (hudFontLoaded) {
            float scaleBaseY = hudY + pad + 40.0f;
            unsigned int fs = 14;
            // Move scale label and input box
            sf::Text moveLabel(hudFont, std::string("Move scale:"), fs);
            moveLabel.setFillColor(sf::Color::White);
            moveLabel.setPosition(sf::Vector2f(hudX + pad, scaleBaseY));
            window.draw(moveLabel);
            // input box for move scale
            float moveInputX = hudX + pad + 160.0f;
            float moveInputY = scaleBaseY;
            float moveInputW = 80.0f;
            float moveInputH = 28.0f;
            sf::RectangleShape moveInputBox(sf::Vector2f(moveInputW, moveInputH));
            moveInputBox.setPosition(sf::Vector2f(moveInputX, moveInputY));
            moveInputBox.setFillColor(sf::Color(220,220,220));
            moveInputBox.setOutlineColor(editMove ? sf::Color::Yellow : sf::Color::Black);
            moveInputBox.setOutlineThickness(1.0f);
            window.draw(moveInputBox);
            std::string showMove = editMove ? moveSpeedStr : std::to_string(moveSpeedScale);
            sf::Text moveText(hudFont, showMove, fs);
            moveText.setFillColor(sf::Color::Black);
            moveText.setPosition(sf::Vector2f(moveInputX + 6.0f, moveInputY));
            window.draw(moveText);

            // Rotation scale label and input box
            rotY = scaleBaseY + 40.0f;
            sf::Text rotLabel(hudFont, std::string("Rot scale:"), fs);
            rotLabel.setFillColor(sf::Color::White);
            rotLabel.setPosition(sf::Vector2f(hudX + pad, rotY));
            window.draw(rotLabel);
            float rotInputX = hudX + pad + 160.0f;
            float rotInputY = rotY;
            float rotInputW = 80.0f;
            float rotInputH = 28.0f;
            sf::RectangleShape rotInputBox(sf::Vector2f(rotInputW, rotInputH));
            rotInputBox.setPosition(sf::Vector2f(rotInputX, rotInputY));
            rotInputBox.setFillColor(sf::Color(220,220,220));
            rotInputBox.setOutlineColor(editRot ? sf::Color::Yellow : sf::Color::Black);
            rotInputBox.setOutlineThickness(1.0f);
            window.draw(rotInputBox);
            std::string showRot = editRot ? rotSpeedStr : std::to_string(rotSpeedScale);
            sf::Text rotText(hudFont, showRot, fs);
            rotText.setFillColor(sf::Color::Black);
            rotText.setPosition(sf::Vector2f(rotInputX + 6.0f, rotInputY));
            window.draw(rotText);

        }

        // Per-robot role toggle (Attack / Defend / Damaged) + state/goal readout
        if (hudFontLoaded) {
            const unsigned int fs = 14;
            for (int i = 0; i < 2; ++i) {
                const float sectionY = rotY + 40.0f + i * 90.0f;
                sf::Text title(hudFont, "Robot " + std::to_string(i + 1), fs);
                title.setFillColor(sf::Color::White);
                title.setPosition(sf::Vector2f(hudX + pad, sectionY));
                window.draw(title);

                const float buttonY = sectionY + 22.0f;
                const float buttonW = 60.0f, buttonH = 24.0f;
                const float atkX = hudX + pad;
                const float defX = atkX + 70.0f;
                const float dmgX = defX + 70.0f;
                const bool isAttacking = !sims[i].damaged && sims[i].publishedState.robotState == RobotState::attacking;
                const bool isDefending = !sims[i].damaged && sims[i].publishedState.robotState == RobotState::defending;

                sf::RectangleShape atkBtn(sf::Vector2f(buttonW, buttonH));
                atkBtn.setPosition(sf::Vector2f(atkX, buttonY));
                atkBtn.setFillColor(isAttacking ? sf::Color(50,200,50) : sf::Color(80,80,80));
                atkBtn.setOutlineThickness(1.0f); atkBtn.setOutlineColor(sf::Color::Black);
                window.draw(atkBtn);
                sf::Text atkText(hudFont, "ATK", fs); atkText.setFillColor(sf::Color::White);
                atkText.setPosition(sf::Vector2f(atkX + 8.0f, buttonY + 3.0f)); window.draw(atkText);

                sf::RectangleShape defBtn(sf::Vector2f(buttonW, buttonH));
                defBtn.setPosition(sf::Vector2f(defX, buttonY));
                defBtn.setFillColor(isDefending ? sf::Color(80,140,220) : sf::Color(80,80,80));
                defBtn.setOutlineThickness(1.0f); defBtn.setOutlineColor(sf::Color::Black);
                window.draw(defBtn);
                sf::Text defText(hudFont, "DEF", fs); defText.setFillColor(sf::Color::White);
                defText.setPosition(sf::Vector2f(defX + 8.0f, buttonY + 3.0f)); window.draw(defText);

                sf::RectangleShape dmgBtn(sf::Vector2f(buttonW, buttonH));
                dmgBtn.setPosition(sf::Vector2f(dmgX, buttonY));
                dmgBtn.setFillColor(sims[i].damaged ? sf::Color(220,50,50) : sf::Color(80,80,80));
                dmgBtn.setOutlineThickness(1.0f); dmgBtn.setOutlineColor(sf::Color::Black);
                window.draw(dmgBtn);
                sf::Text dmgText(hudFont, "DMG", fs); dmgText.setFillColor(sf::Color::White);
                dmgText.setPosition(sf::Vector2f(dmgX + 6.0f, buttonY + 3.0f)); window.draw(dmgText);

                std::string statusText = sims[i].damaged
                    ? "State: damaged (removed from field)"
                    : "State: " + std::string(robotStateName(sims[i].publishedState.robotState)) +
                      "  Goal: " + std::string(robotGoalName(sims[i].publishedState.robotGoal));
                sf::Text status(hudFont, statusText, fs);
                status.setFillColor(sf::Color(220, 220, 255));
                status.setPosition(sf::Vector2f(hudX + pad, buttonY + 32.0f));
                window.draw(status);
            }
        }

        // HUD: compact per-robot BallPacket/MoveProfile/dribbler debug readout
        if (hudFontLoaded) {
            const float HUD_CONTROLS_HEIGHT = rotY - hudY + 40.0f + 2 * 90.0f + 10.0f; // controls + both role sections
            float tx = hudX + pad;
            float ty = hudY + HUD_CONTROLS_HEIGHT;
            unsigned int fs = 14;
            for (int i = 0; i < 2; ++i) {
                std::string line1 = "R" + std::to_string(i + 1) + " ball: bearing=" +
                    std::to_string(ballBearingDeg[i]) + " dist=" + std::to_string(ballDistCm[i]) + "cm";
                std::string line2 = "R" + std::to_string(i + 1) + " move: active=" +
                    (moveProfiles[i].active ? "Y" : "N") + " spd=" + std::to_string(moveProfiles[i].speed) +
                    " rot=" + std::to_string(moveProfiles[i].rotationSpeed);
                std::string line3 = "R" + std::to_string(i + 1) + " dribble=" +
                    (dribblerFlags[i] ? "ON" : "off") + "  holding=" + (ballHolderIndex == i ? "YES" : "no");

                sf::Text t1(hudFont, line1, fs); t1.setFillColor(sf::Color::White); t1.setPosition(sf::Vector2f(tx, ty)); window.draw(t1); ty += 20.0f;
                sf::Text t2(hudFont, line2, fs); t2.setFillColor(sf::Color::White); t2.setPosition(sf::Vector2f(tx, ty)); window.draw(t2); ty += 20.0f;
                sf::Text t3(hudFont, line3, fs); t3.setFillColor(ballHolderIndex == i ? sf::Color(140, 255, 140) : sf::Color(255, 220, 140));
                t3.setPosition(sf::Vector2f(tx, ty)); window.draw(t3); ty += 28.0f;
            }
        }

        window.display();
    }

    // Stop both robot threads cleanly
    robot_stop(0);
    robot_stop(1);

    return 0;
}
