class-ab/open-soccer/software/simulation/src/sim_state.cpp

#include "subsystems/robot_state.h"

// Simple definitions of the globals the simulator will read/write.
// The real robot firmware provides its own definitions when linked; the
// simulator builds standalone and therefore defines them here.

BallPacket latestBallPacket = {false, 0.0f, 0.0f, 0};
unsigned long lastBallPacketMs = 0;

MoveProfile currentMoveProfile = {false, 0.0f, 0.0f, 0.0f, 0};
