class-ab/open-soccer/(commit log)

2026-02-19 Update soccer bottom.kicad_sch
    [soccer bottom.kicad_sch]
2026-02-20 v10 or smting
    [soccer bottom.kicad_pcb]
2026-02-20 20/2/26 test 1 final
    [soccer bottom.kicad_pcb]
2026-03-08 NEW MCU
    rp2040-zero and mosfets
    grr haven't made the pcb
    schematic is good tho!
    [soccer bottom.kicad_pcb, soccer bottom.kicad_sch]
2026-03-09 update parts list
    [ov5640.step]
2026-03-18 100k to 10k
    [soccer bottom.kicad_sch]
2026-03-26 boost circuit v1
    [boost.kicad_pcb, boost.kicad_sch]
2026-03-30 kicker update
    [boost.kicad_sch, kicker.kicad_pcb, kicker.kicad_sch]
2026-03-31 kicad update?
    [DEV-15583--3DModel-STEP-56544.STEP, DEV-15583.step, DEV-16771--3DModel-STEP-418109.STEP, DEV-16771.step, RP2040-ZERO--3DModel-STEP-418109.STEP, RP2040-ZERO.step]
2026-03-31 kicker actual start
    [UCC27624DR.step, kicker.kicad_pcb, kicker.kicad_sch]
2026-03-31 fix driver footprint
    [kicker.kicad_pcb, kicker.kicad_sch]
2026-04-01 kicker v0.1
    [kicker.kicad_pcb, kicker.kicad_sch]
2026-04-06 kicker schematic reorganise
    [kicker.kicad_sch]
2026-04-12 kicker board and outline
    [kicker.kicad_pcb, kicker.kicad_sch]
2026-04-13 kicker V1
    [kicker.kicad_pcb, kicker.kicad_sch]
2026-04-13 export v1
    [bom.csv, designators.csv, kicker.kicad_pcb, positions.csv]
2026-04-14 bottom pcb update
    [soccer bottom.kicad_pcb, soccer bottom.kicad_sch, soccer bottom.step]
2026-04-15 bottom v2 (pcb)
    [bom.csv, designators.csv, positions.csv, soccer bottom.kicad_pcb, soccer bottom.kicad_sch]
2026-04-18 kicker v2 review
    [kicker.kicad_pcb, kicker.kicad_sch]
2026-04-19 kicker v2
    [kicker.kicad_pcb, kicker.kicad_sch]
2026-04-19 kicker v2.1
    [kicker.kicad_pcb, kicker.kicad_sch]
2026-04-25 bottom align
    [bottom PCB.step, kicker.kicad_pcb, kicker.step, soccer bottom.kicad_pcb]
2026-04-25 kicker fix
    [kicker.kicad_pcb, kicker.kicad_sch]
2026-05-03 middle pcb schematic
    [4754.step, kicker.kicad_pcb, middle.kicad_pcb, middle.kicad_sch]
2026-05-03 middle v2
    [middle.kicad_pcb, middle.kicad_sch]
2026-05-05 kicker rotate diode
    [kicker.kicad_pcb, kicker.kicad_sch]
2026-05-07 middle revision
    [DM-OLED096-636.step, middle.kicad_pcb, middle.kicad_sch]
2026-05-08 mainboard layout
    [middle.kicad_pcb, middle.kicad_sch]
2026-05-11 middle BANANA board layout, wiring
    [freerouting.dsn, middle.kicad_pcb, middle.kicad_sch, temp-freerouting.dsn]
2026-05-12 middle update
    [middle.kicad_pcb]
2026-05-23 main update
    [RFM98W-433S2.STEP, bottom PCB.step, freerouting.dsn, kicker.kicad_pcb, kicker.kicad_sch, middle.kicad_pcb, middle.kicad_sch, temp-freerouting.dsn]
2026-05-25 nrf middle update 1 (NOT DONE)
    [middle.kicad_pcb, middle.kicad_sch]
2026-05-31 final edit lol
    [bottom PCB.step, kicker.step]
2026-06-02 pcb final final final?
    [middle.kicad_pcb]
2026-06-02 final v4 add esc to middle
    [middle.kicad_pcb, middle.kicad_sch]
2026-06-08 ORDERED PCBS
    [bom.csv, designators.csv, middle.kicad_pcb, positions.csv]
2026-06-22 add CAD to README.md
2026-07-12 mirror generator code
    [mirror_profile.csv, mirror_profile.dxf, mirror_profile_points.dxf]
2026-07-25 remove button for moving in square
2026-07-25 moved .h files to correct location
    [main.cpp, robot_config.h]
2026-07-25 updated battery shutdown voltage to 14.8 volts
2026-07-25 removed double running update imu
2026-08-01 created separete checkEnabledButton function. moved "now" time to be global in robot.cpp (not just in robottick) fixed if/else logic
    [robot.cpp]
2026-08-01 moved "now" back into systemtick, declare checkenabledbutton at start of robot.cpp, fix debounce and if logic
    [robot.cpp]
2026-08-01 set lastbutton1state at end of checkenabled button function
2026-08-03 mirror v6 update code and shape
    [mirror_profile.csv, mirror_profile.dxf, mirror_profile_points.dxf]
2026-08-03 whoops forgot the files, added now
    [mirror_profile.csv, mirror_profile.dxf, mirror_profile_points.dxf]
2026-08-07 stop drive motors if disabled
2026-08-14 first working simulation, currently separete to the robotcode and dosnt input or output to/from robotcode
2026-08-14 Gave goals collisions and flipped to extend the correct side of field
    [main.cpp]
2026-08-15 working collisions and ball physics(ish)
    [main.cpp]
2026-09-03 lidar with rotation for no IMU v1 untested
2026-09-04 lidar fixes
2026-09-08 1: lidar code implement and display
2026-09-08 1.1: fix display and robotPose API fetch
    [display.cpp]
2026-09-12 3: fix includes, finish ballState with 9 detections (/10)
    [robot.cpp, strategy.cpp]
2026-09-15 3: finished v1 robot stategy: - updateStrategy done - communication send state - swap attack/defend - local/remote changes - UNTESTED ANYTHING - RobotGoal, RobotState differentation - next: make actu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
    [communication.cpp, robot.cpp, robot_config.h, robot_state.cpp, strategy.cpp]
2026-09-15 3.1: bug fixes lol
    [strategy.cpp]
2026-09-20 1.2: boot mode check: 2nd IMU dead?
2026-09-20 2: fix attacker/defender/1/2 button1, being move() commands, remove chaseTick and systemTick, implement awayBorder, rewrite robot_config.h
    [communication.cpp, display.cpp, robot.cpp, robot_config.h, strategy.cpp, vision.cpp]
2026-09-21 3.1: fixed headings, goal locations, still untested
    [strategy.cpp]
2026-09-23 2: THINK fixed localisation, readded opponents, updated display
    [display.cpp, localization.cpp, robot_config.h]
2026-09-23 3: update IMU heading
2026-09-24 1.1: fixed rotation issues? untested
    [localization.cpp]
2026-09-24 3: fix buttons, add enable button back again
    [robot.cpp, robot_state.cpp]
2026-09-24 3.1: buttons fix (still have to hold down!!!!)
    [display.cpp, robot.cpp, robot_config.h, robot_state.cpp]
2026-09-25 MHS: fix openmv, add debug, add moveTo() pose projection (untested)
    [display.cpp, drivebase.cpp, localization.cpp, openmv.py, robot_config.h, strategy.cpp]
2026-09-25 make drive parallel: stops some issues?
    [drivebase.cpp, openmv.py, robot_config.h, solenoidTestFinal.ino, strategy.cpp, teensy_aerostar_esc.ino]
2026-09-26 NEW LIDAR DONE
2026-09-26 kinda gets to location? doesn't work
    [drivebase.cpp, localization.cpp, robot.cpp, robot_config.h]
2026-09-26 FIXED IT: now being PID tuning
    [localization.cpp, robot.cpp, robot_config.h]
2026-09-26 communication test true, start tuning PID. all is wrong LOL, acceleration + speed too. need to update comunication faster/stronger/robuster + fix damaged!!!
    [communication.cpp, display.cpp, robot.cpp, robot_config.h, strategy.cpp]
2026-09-27 defence commit 1: need to fix everything
    [robot_config.h, strategy.cpp]
2026-09-29 defense finished, reset/location fixes
    [main.cpp, robot_config.h, strategy.cpp]
2026-10-01 SIML pause button, fix kicker
    [main.cpp, strategy.cpp]
2026-10-01 finish attack (v4) logic; need to add state switching + interchange
2026-10-01 added attacker own-goal avoidance
    [main.cpp, strategy.cpp]
2026-10-01 fixed state swapping!!! added damaged-state swap and attack/defense swap based on ball possession
    [communication.cpp, robot_state.cpp, strategy.cpp]
2026-10-02 update TESTING lidarFinal code
2026-10-02 update dribbler strategy, PID/speed/accel
2026-10-03 lidar change, distance increase
2026-10-03 pid tune, jeffery match
